Roboy/m3/README.md

# m3
myo mini muscle
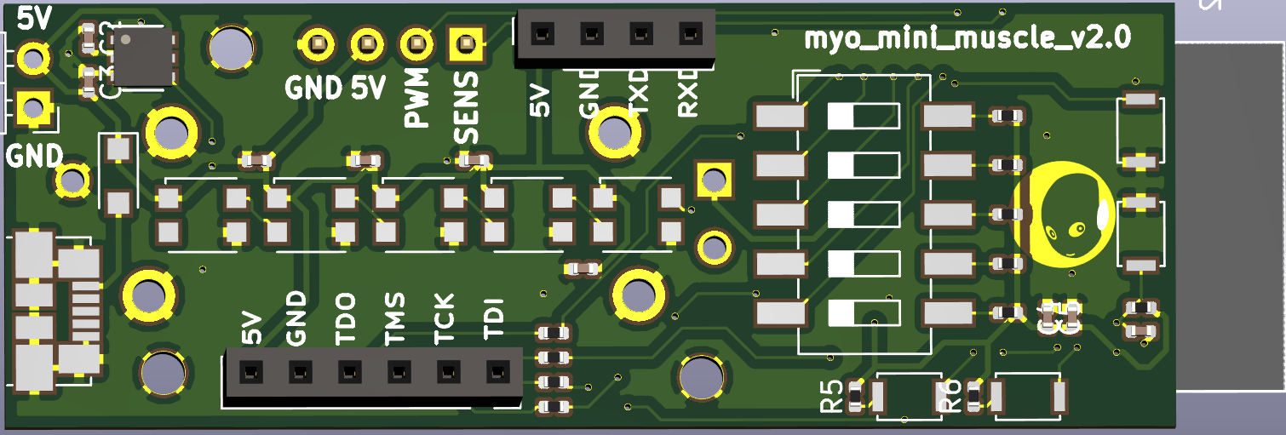
[picture p1: images/m3.png]
m3

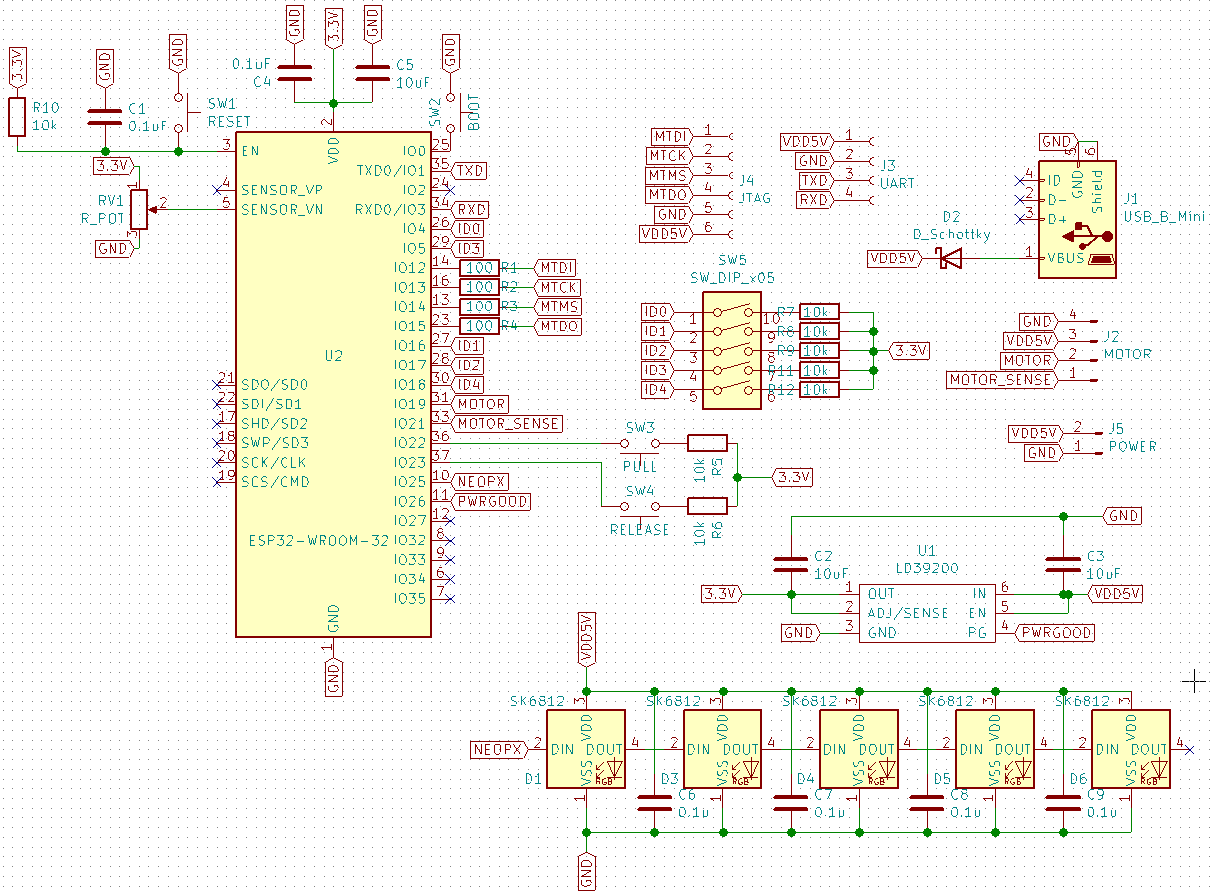
[picture p2: images/m3_schematics.png]
m3_schematics
