Roboy/m3/datasheet/esp32-pinout-chip-ESP-WROOM-32.png

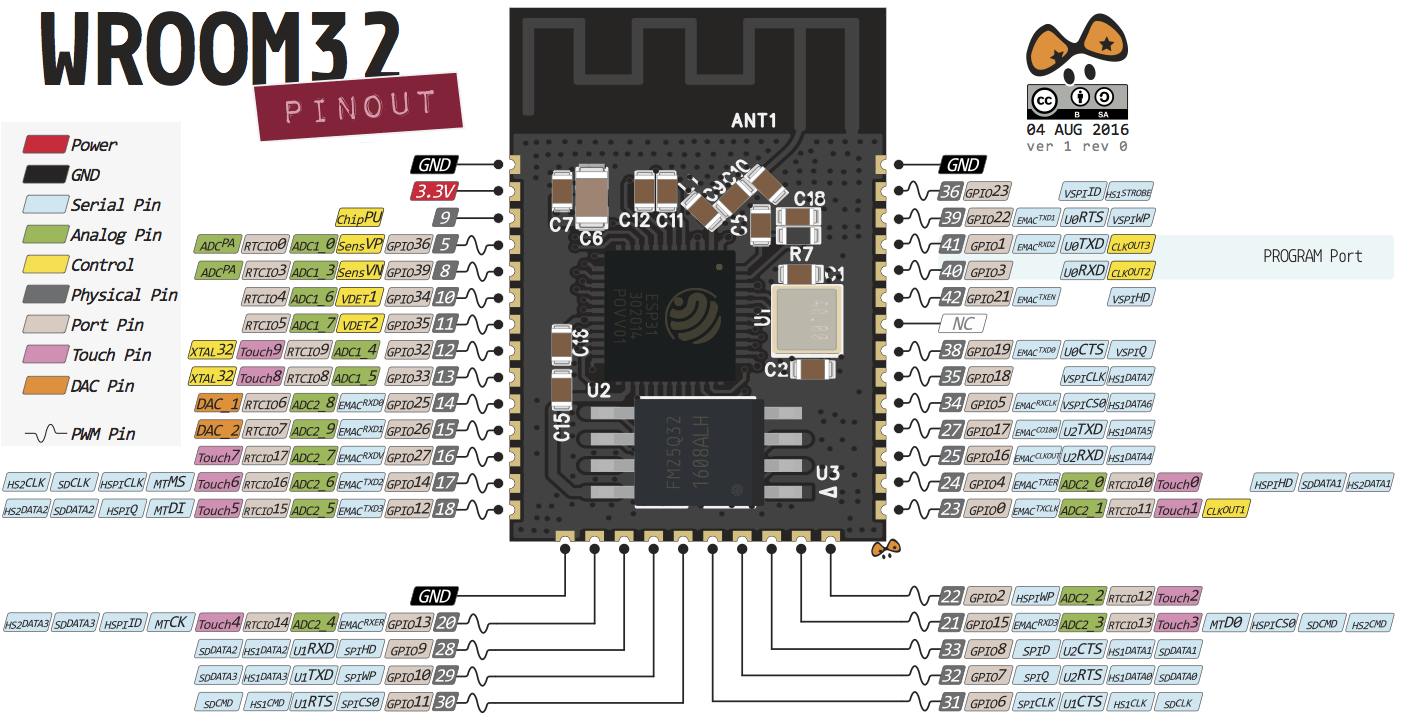
datasheet/esp32-pinout-chip-ESP-WROOM-32.png
