Roboy/m3/_3Dmodels/4UCON_17809/4UCON_17809_02x10x1.27mm_Vertical.step

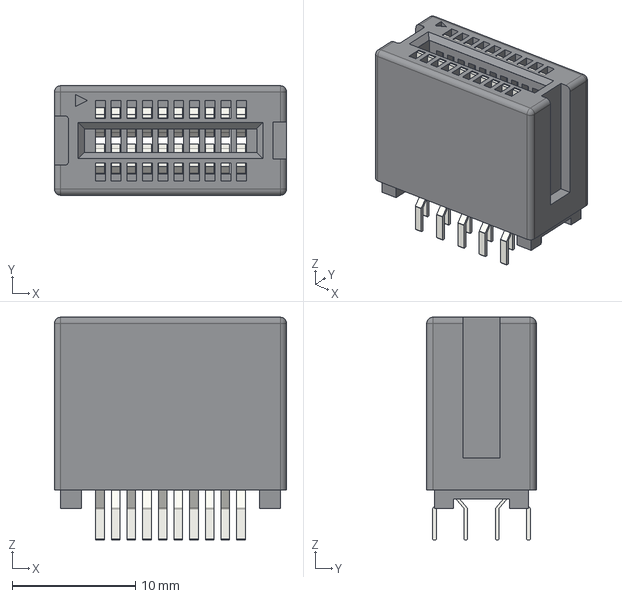
[picture p4: CAD file, 2019-02-02]
_3Dmodels/4UCON_17809/4UCON_17809_02x10x1.27mm_Vertical.step
18.8 x 8.88 x 18.0 mm
