Roboy/m3/_3Dmodels/BGA_packages/Texas_Junior_DSBGA-12_4x3_2.5x2.0mm_Pitch0.5mm_Dia0.30mm.step

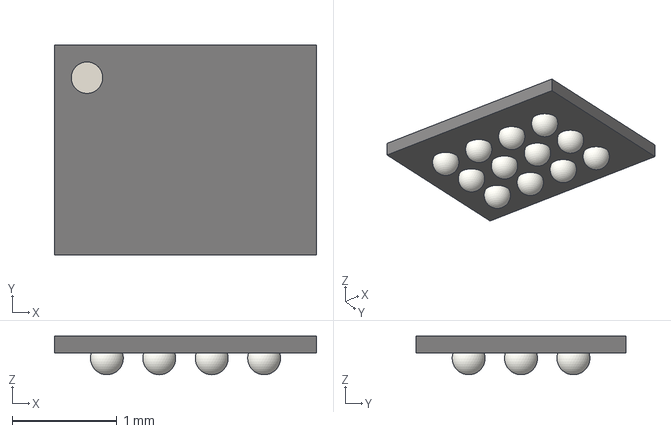
[picture p5: CAD file, 2019-02-02]
_3Dmodels/BGA_packages/Texas_Junior_DSBGA-12_4x3_2.5x2.0mm_Pitch0.5mm_Dia0.30mm.step
2.50 x 2.00 x 0.367 mm
