Roboy/m3/_3Dmodels/Box_Headers/Box_Header_Straight_2x25x2.54mm.step

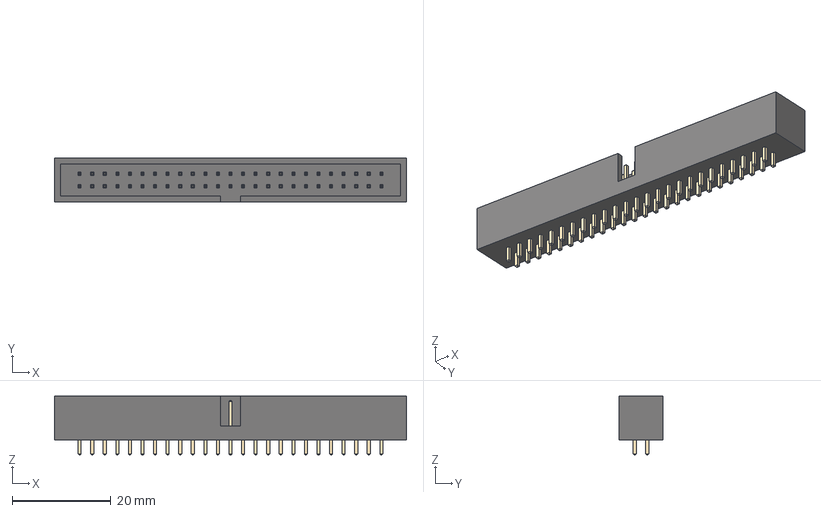
[picture p6: CAD file, 2019-02-02]
_3Dmodels/Box_Headers/Box_Header_Straight_2x25x2.54mm.step
71.1 x 8.90 x 11.9 mm
