Roboy/m3/_3Dmodels/Capacitors_Radial_THT/CP_Radial_D10.0mm_P7.50mm.step

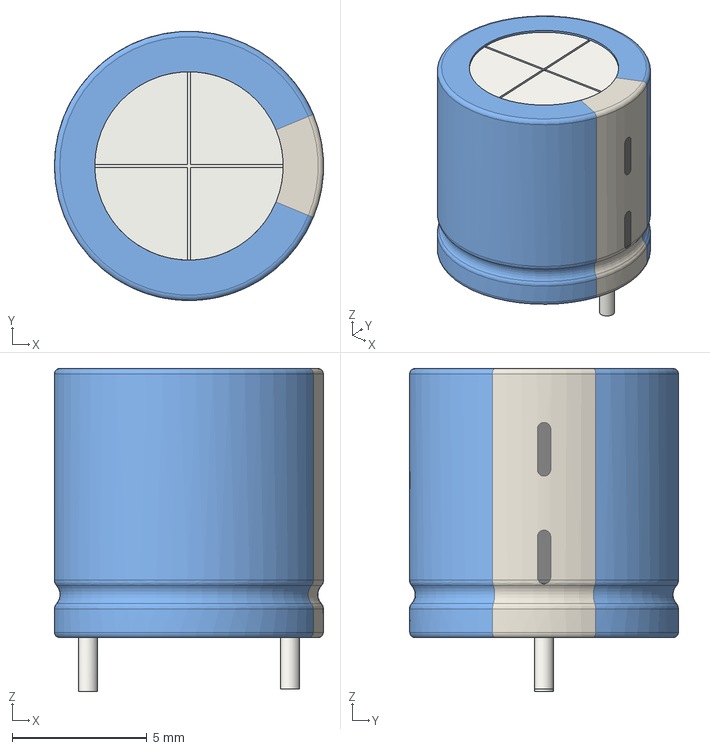
[picture p8: CAD file, 2019-02-02]
_3Dmodels/Capacitors_Radial_THT/CP_Radial_D10.0mm_P7.50mm.step
10.00 x 9.99 x 12.0 mm
