Roboy/m3/_3Dmodels/Capacitors_Rect_THT/C_Rect_L4.6mm_W5.5mm_P2.50mm_MKS02_FKP02.step

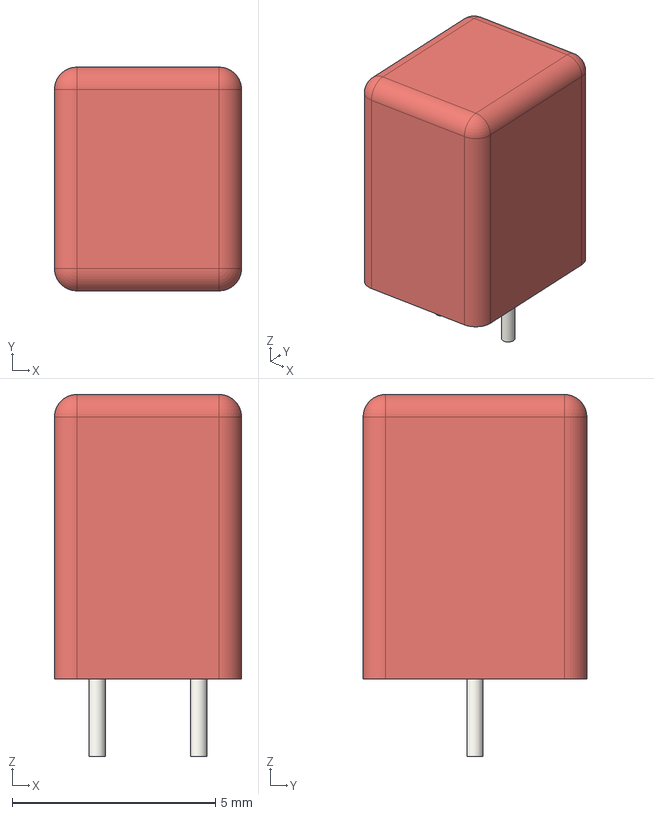
[picture p9: CAD file, 2019-02-02]
_3Dmodels/Capacitors_Rect_THT/C_Rect_L4.6mm_W5.5mm_P2.50mm_MKS02_FKP02.step
4.60 x 5.50 x 8.90 mm
