Roboy/m3/_3Dmodels/Diodes_SMD/D_SMA.step

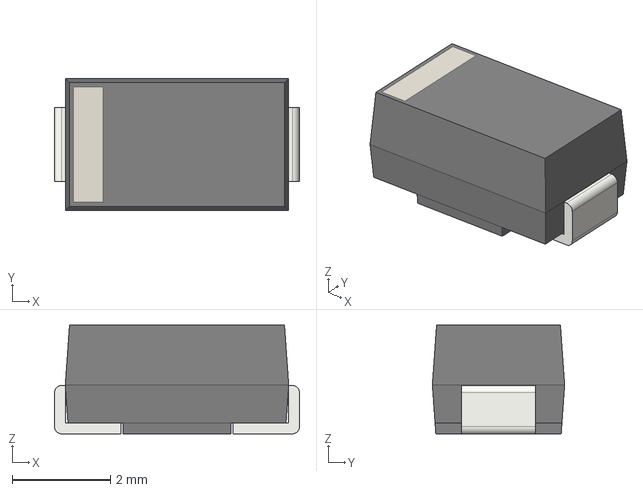
[picture p10: CAD file, 2019-02-02]
_3Dmodels/Diodes_SMD/D_SMA.step
5.00 x 2.70 x 2.22 mm
