Roboy/m3/_3Dmodels/ESP32/ESP32-WROOM-32D--3DModel-STEP-56544.STEP

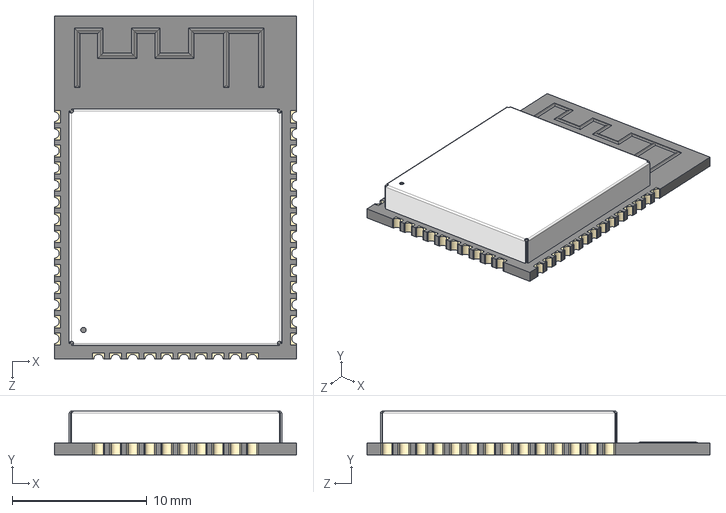
[picture p12: CAD file, 2019-05-12]
_3Dmodels/ESP32/ESP32-WROOM-32D--3DModel-STEP-56544.STEP
18.0 x 3.25 x 25.5 mm
