Roboy/m3/roboy_sno1.step

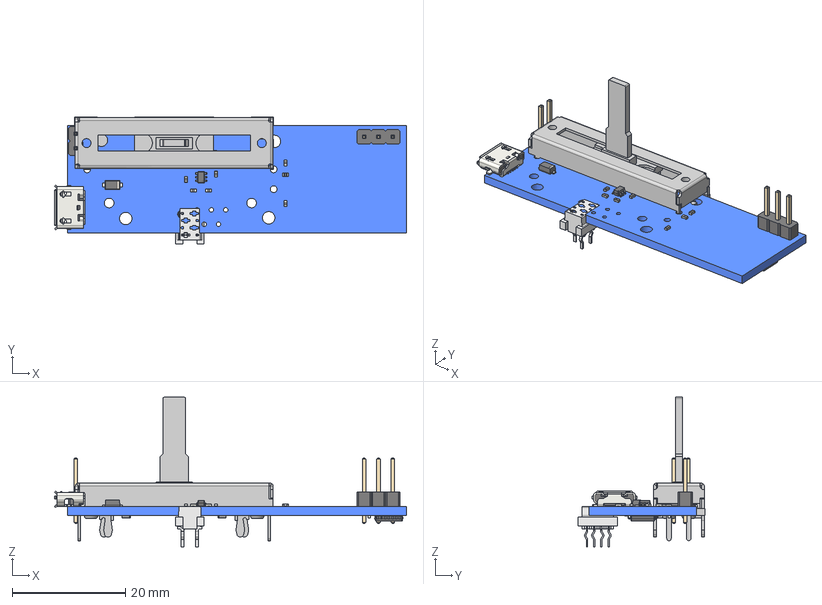
[picture p15: CAD file, 2019-02-02]
roboy_sno1.step
62.3 x 22.5 x 26.4 mm
Pcb
Potentiometer_Bourns_PTA2043_Single_Slide_
DFN_6_1EP_3x3mm_Pitch095mm_
C_0402_
C_0402_001
D_SOD_123F_
USB_Micro-B_Molex_47346-0001_
PinHeader_1x02_P254mm_Vertical_
SOT_363_SC_70_6_
R_0402_
R_0402_001
R_0402_002
R_0402_003
C_0402_002
C_0402_003
PinHeader_1x03_P254mm_Vertical_
TSSOP_14_44x5mm_Pitch065mm_
R_0402_004
R_0402_005
R_0402_006
C-215079-4_
R_0402_1005Metric_
R_0402_1005Metric_001
R_0402_1005Metric_002
