Roboy/m3/_3Dmodels/4UCON_17809/4UCON_17809_02x40x1.27mm_Vertical.FCStd

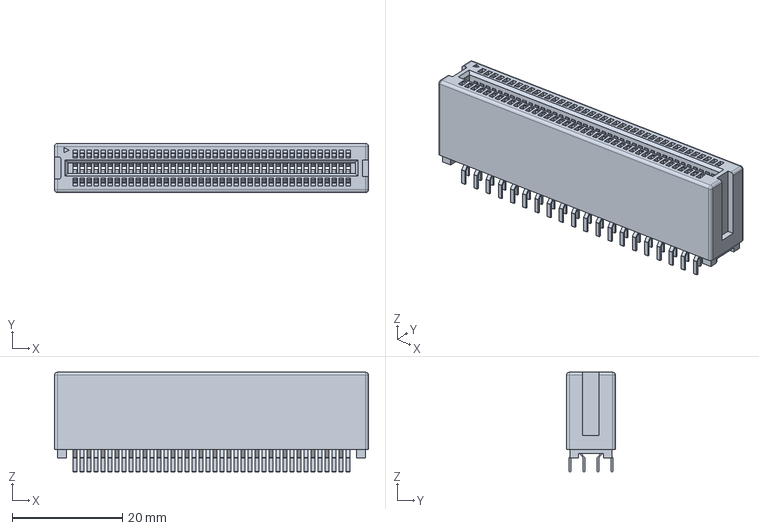
[picture p16: CAD file, 2019-02-02]
_3Dmodels/4UCON_17809/4UCON_17809_02x40x1.27mm_Vertical.FCStd
56.9 x 8.88 x 18.0 mm
