Roboy/m3/_3Dmodels/Capacitors_Radial_SMD/CP_Elec_8x6.5.step

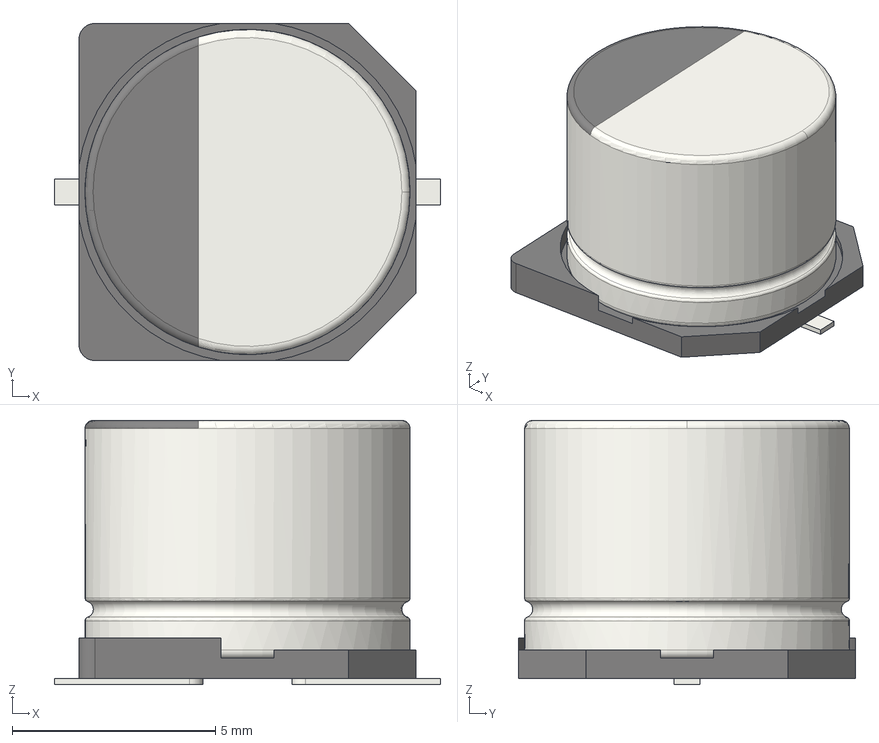
[picture p19: CAD file, 2019-02-02]
_3Dmodels/Capacitors_Radial_SMD/CP_Elec_8x6.5.step
9.50 x 8.30 x 6.50 mm
