Roboy/m3/_3Dmodels/Capacitors_Radial_THT/CP_Radial_D8.0mm_P5.00mm.step

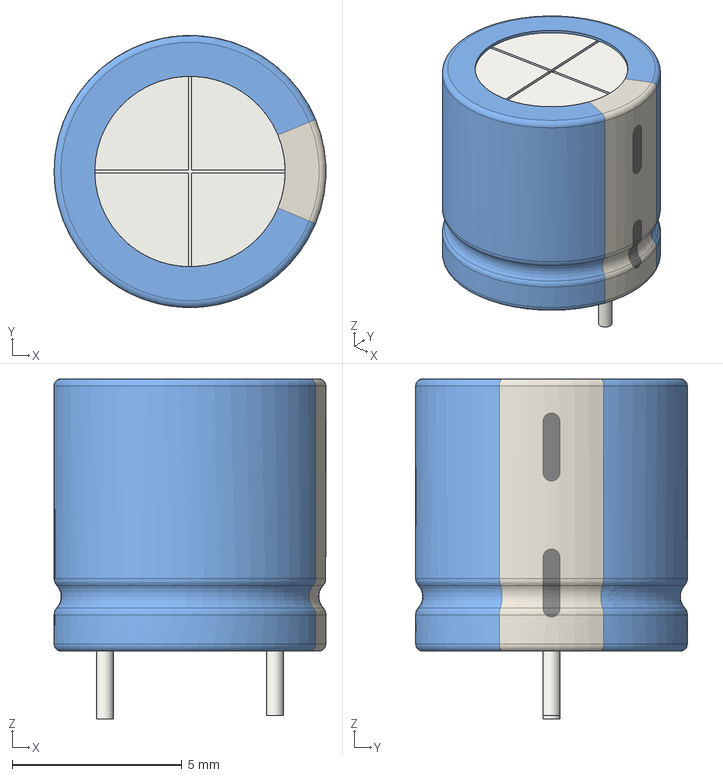
[picture p20: CAD file, 2019-02-02]
_3Dmodels/Capacitors_Radial_THT/CP_Radial_D8.0mm_P5.00mm.step
8.00 x 8.00 x 10.0 mm
