Roboy/m3/_3Dmodels/Diodes_SMD/D_SMC.step

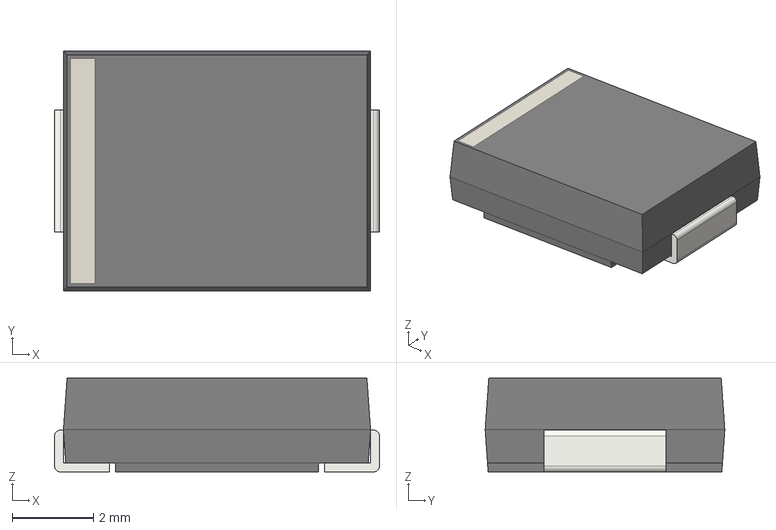
[picture p22: CAD file, 2019-02-02]
_3Dmodels/Diodes_SMD/D_SMC.step
8.00 x 5.90 x 2.31 mm
