Roboy/m3/_3Dmodels/DIP_packages/DIP-24_W10.16mm.step

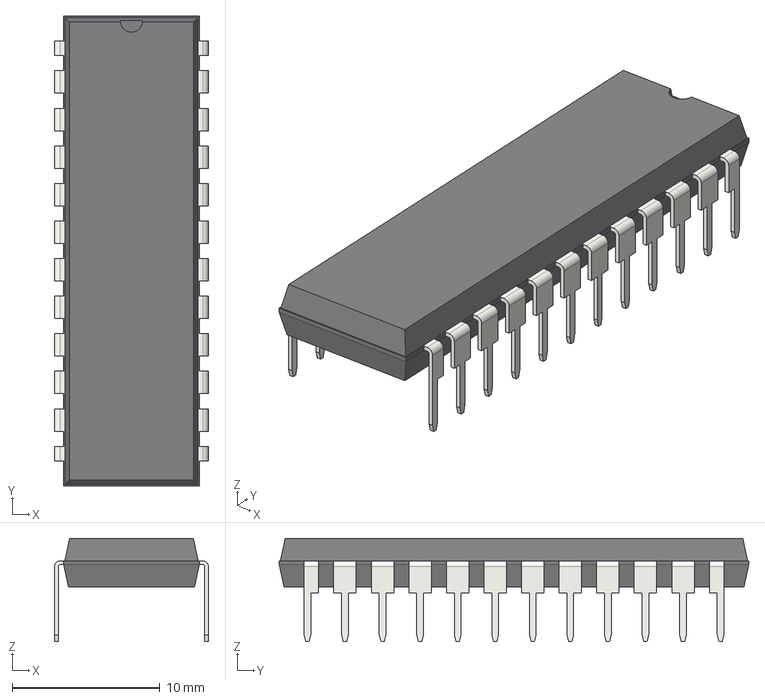
[picture p23: CAD file, 2019-02-02]
_3Dmodels/DIP_packages/DIP-24_W10.16mm.step
10.4 x 31.8 x 6.98 mm
