Roboy/m3/_3Dmodels/GullWings_packages/QFP/LQFP-44_10x10mm_Pitch0.8mm.step

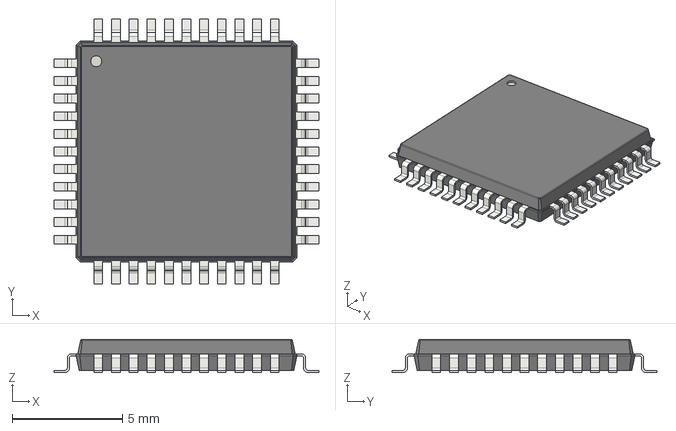
[picture p24: CAD file, 2019-02-02]
_3Dmodels/GullWings_packages/QFP/LQFP-44_10x10mm_Pitch0.8mm.step
12.0 x 12.0 x 1.50 mm
