Roboy/m3/_3Dmodels/BGA_packages/BGA-1156_34x34_35.0x35.0mm_Pitch1.0mm.step

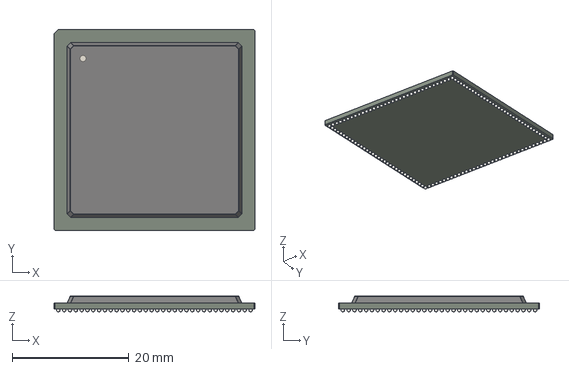
[picture p26: CAD file, 2019-02-02]
_3Dmodels/BGA_packages/BGA-1156_34x34_35.0x35.0mm_Pitch1.0mm.step
34.5 x 34.5 x 2.72 mm
