Roboy/m3/_3Dmodels/Capacitors_Rect_THT/C_Rect_L11.5mm_W6.4mm_P10.00mm_MKT.step

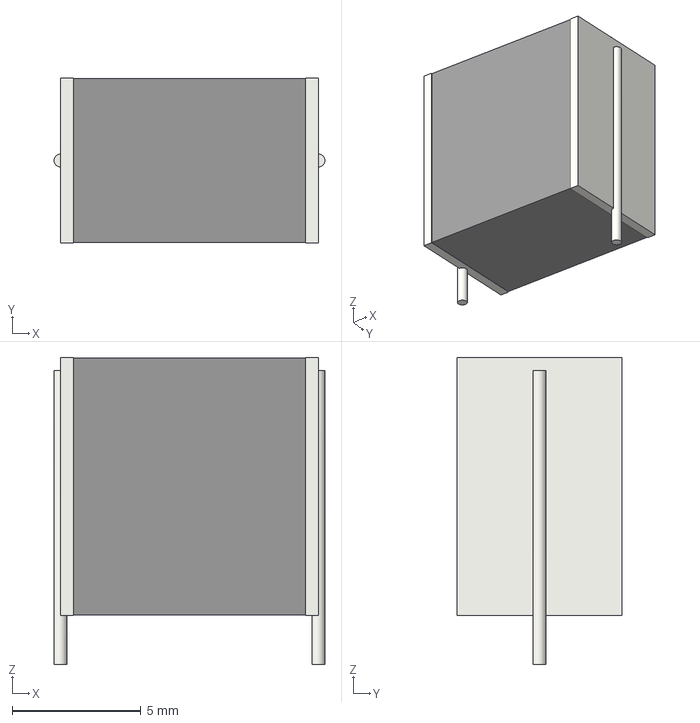
[picture p29: CAD file, 2019-02-02]
_3Dmodels/Capacitors_Rect_THT/C_Rect_L11.5mm_W6.4mm_P10.00mm_MKT.step
10.5 x 6.40 x 11.9 mm
