Roboy/m3/_3Dmodels/Diodes_SMD/D_SMB.step

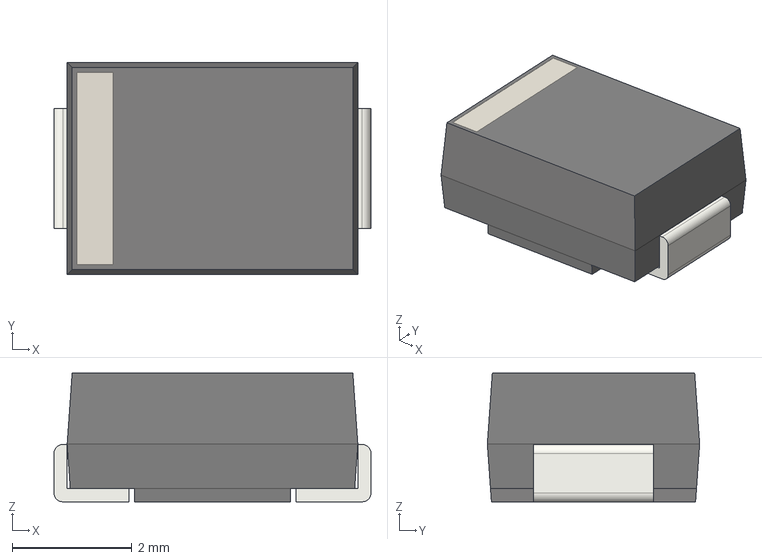
[picture p30: CAD file, 2019-02-02]
_3Dmodels/Diodes_SMD/D_SMB.step
5.30 x 3.55 x 2.15 mm
