Roboy/m3/_3Dmodels/DIP_packages/DIP-64_W22.86mm.step

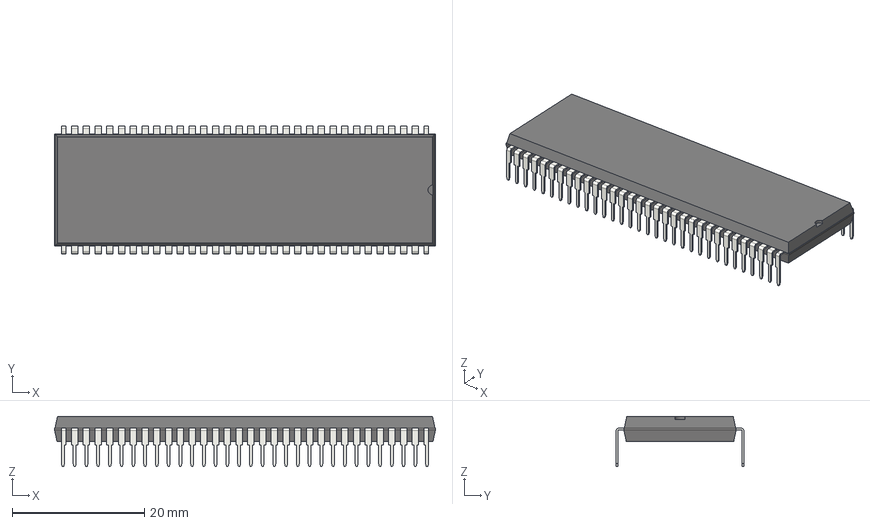
[picture p31: CAD file, 2019-02-02]
_3Dmodels/DIP_packages/DIP-64_W22.86mm.step
57.7 x 19.3 x 7.62 mm
