Roboy/m3/_3Dmodels/GullWings_packages/QFP/LQFP-128_14x14mm_Pitch0.4mm.step

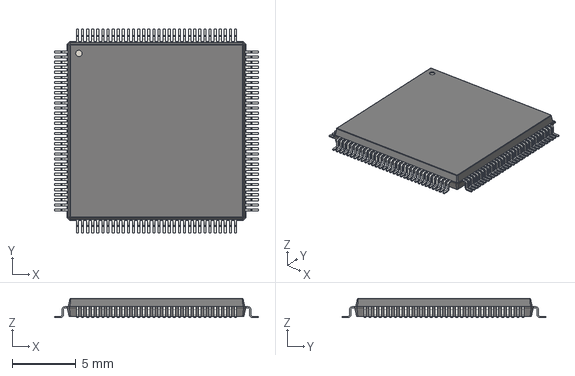
[picture p32: CAD file, 2019-02-02]
_3Dmodels/GullWings_packages/QFP/LQFP-128_14x14mm_Pitch0.4mm.step
16.0 x 16.0 x 1.50 mm
