Roboy/m3/_3Dmodels/GullWings_packages/SOIC/SOIC-20W_7.5x12.8mm_Pitch1.27mm.step

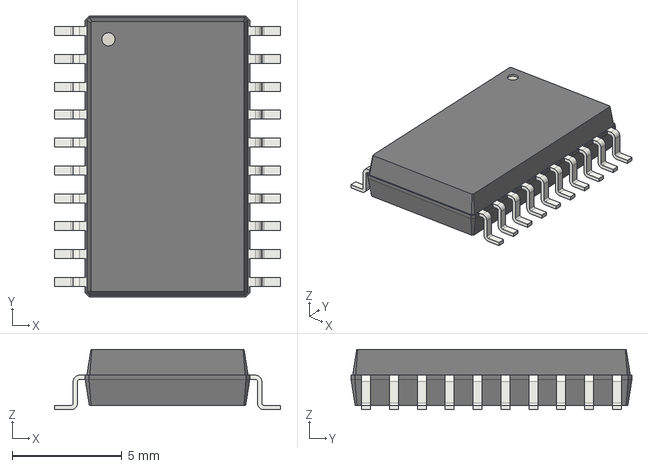
[picture p33: CAD file, 2019-02-02]
_3Dmodels/GullWings_packages/SOIC/SOIC-20W_7.5x12.8mm_Pitch1.27mm.step
10.3 x 12.8 x 2.75 mm
