Roboy/m3/_3Dmodels/Capacitors_Radial_THT/CP_Radial_D10.0mm_P3.80mm.step

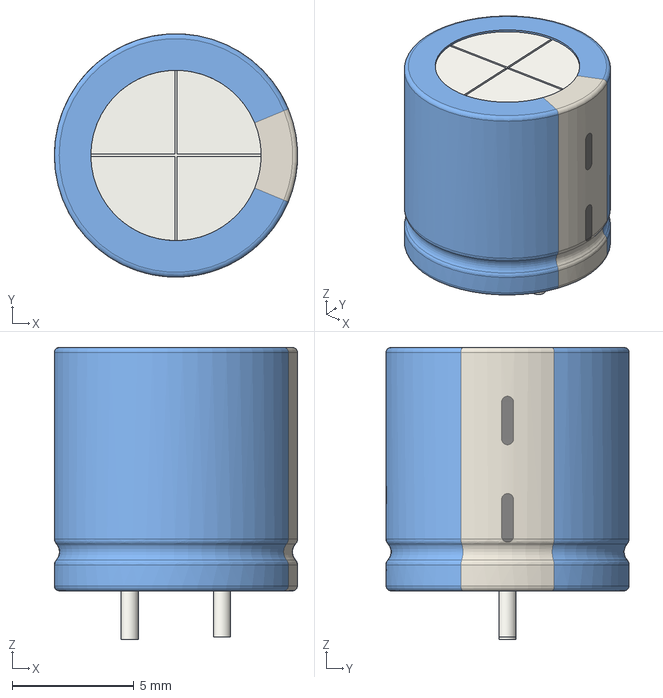
[picture p37: CAD file, 2019-02-02]
_3Dmodels/Capacitors_Radial_THT/CP_Radial_D10.0mm_P3.80mm.step
10.00 x 9.99 x 12.0 mm
