Roboy/m3/_3Dmodels/Capacitors_Rect_THT/C_Rect_L26.5mm_W8.5mm_P22.50mm_MKS4.step

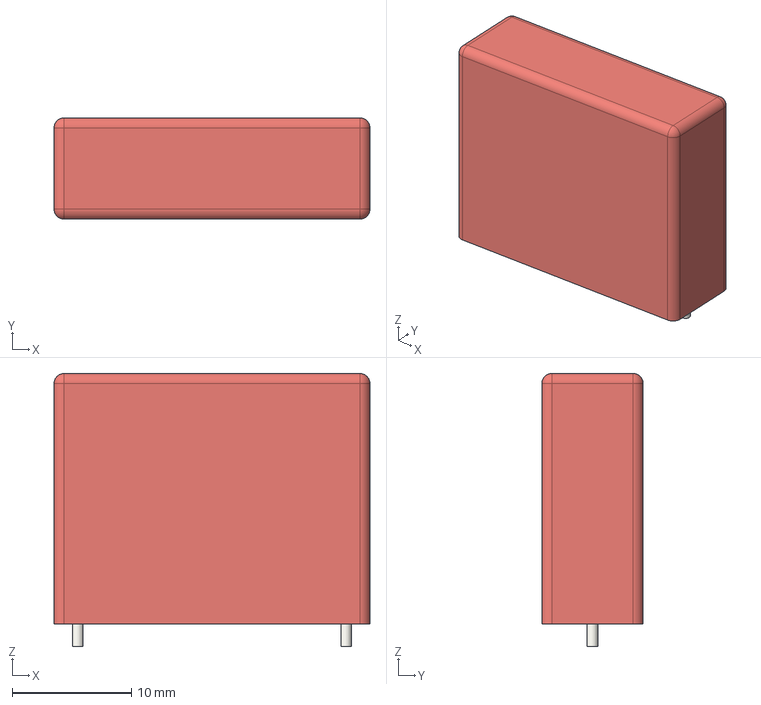
[picture p38: CAD file, 2019-02-02]
_3Dmodels/Capacitors_Rect_THT/C_Rect_L26.5mm_W8.5mm_P22.50mm_MKS4.step
26.5 x 8.50 x 22.9 mm
