Roboy/m3/_3Dmodels/DIP_packages/DIP-4_W7.62mm.step

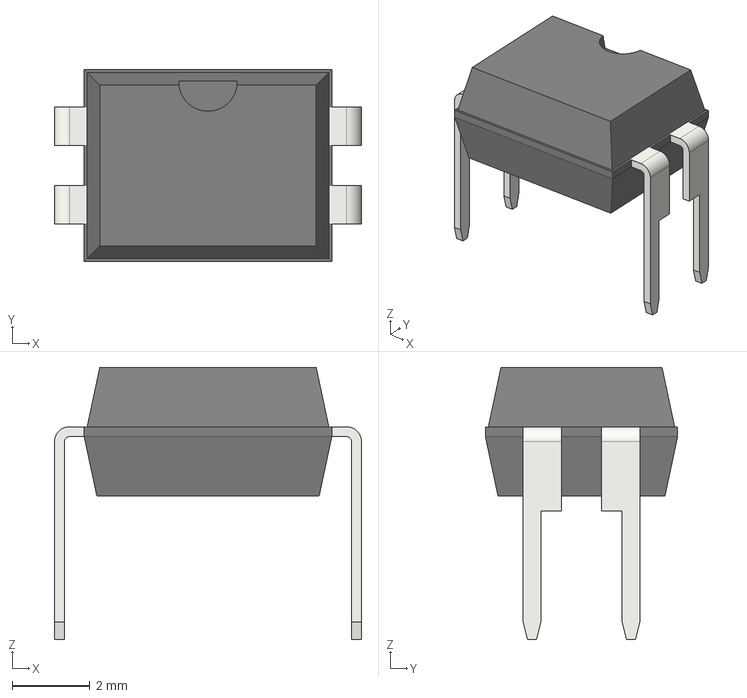
[picture p39: CAD file, 2019-02-02]
_3Dmodels/DIP_packages/DIP-4_W7.62mm.step
7.87 x 4.93 x 6.98 mm
