Roboy/m3/_3Dmodels/GullWings_packages/QFP/LQFP-32_5x5mm_Pitch0.5mm.step

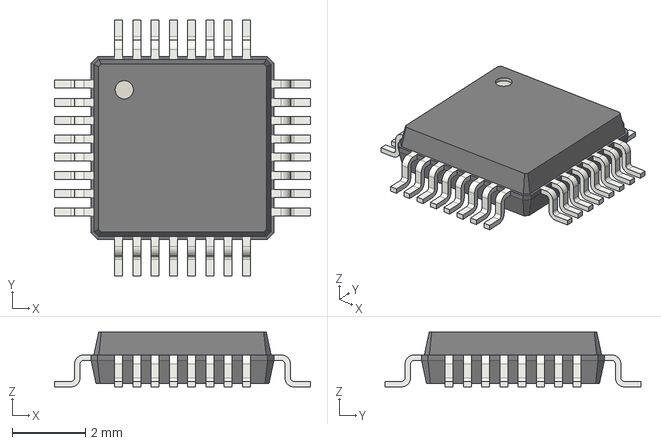
[picture p40: CAD file, 2019-02-02]
_3Dmodels/GullWings_packages/QFP/LQFP-32_5x5mm_Pitch0.5mm.step
7.00 x 7.00 x 1.50 mm
