Roboy/m3/_3Dmodels/GullWings_packages/SOIC/SOIC-16_3.9x9.9mm_Pitch1.27mm.step

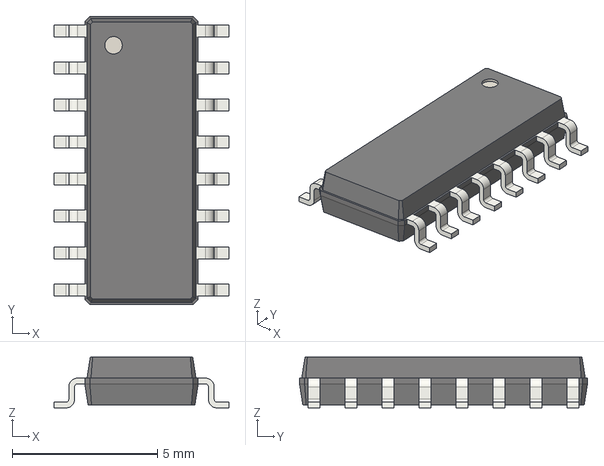
[picture p41: CAD file, 2019-02-02]
_3Dmodels/GullWings_packages/SOIC/SOIC-16_3.9x9.9mm_Pitch1.27mm.step
6.00 x 9.90 x 1.75 mm
