Roboy/m3/_3Dmodels/Capacitors_Radial_SMD/CP_Elec_6.3x5.8.step

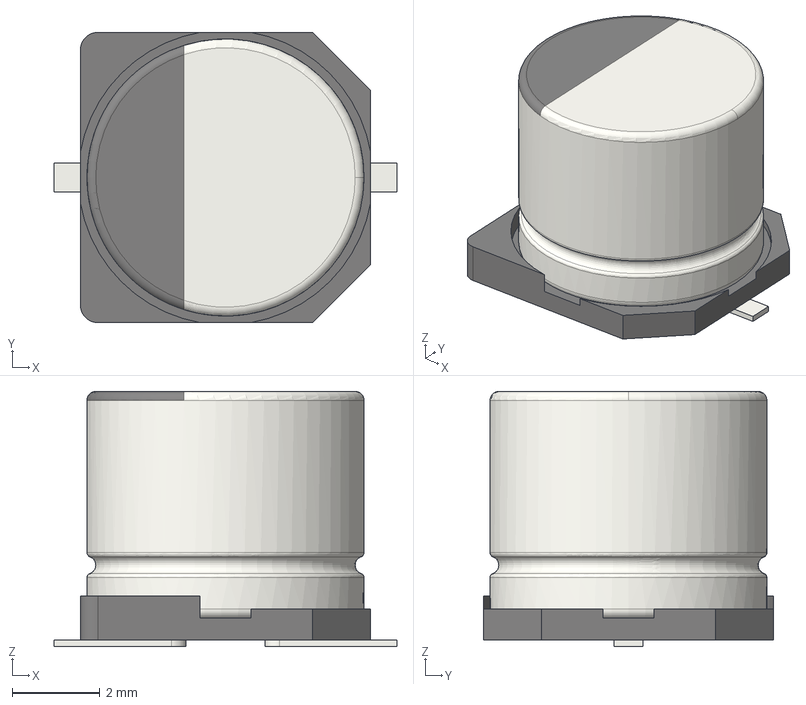
[picture p44: CAD file, 2019-02-02]
_3Dmodels/Capacitors_Radial_SMD/CP_Elec_6.3x5.8.step
7.80 x 6.60 x 5.80 mm
