Roboy/m3/_3Dmodels/Capacitors_Rect_THT/C_Rect_L7.0mm_W2.0mm_P5.00mm.step

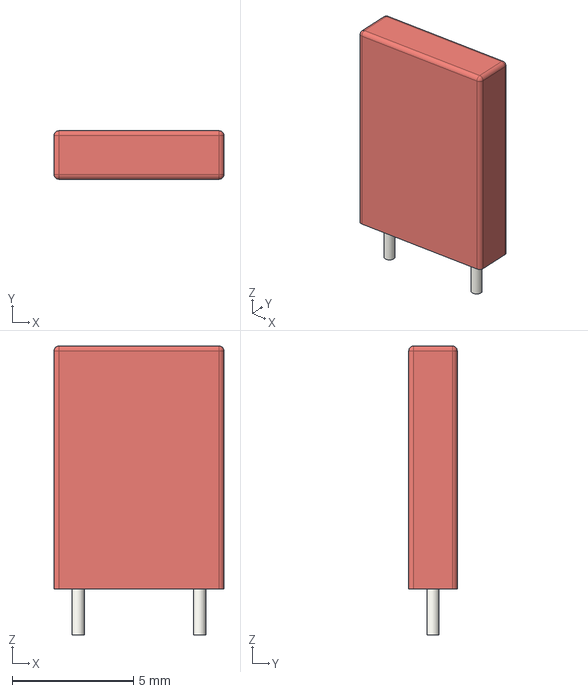
[picture p46: CAD file, 2019-02-02]
_3Dmodels/Capacitors_Rect_THT/C_Rect_L7.0mm_W2.0mm_P5.00mm.step
7.00 x 2.00 x 11.9 mm
