Roboy/m3/_3Dmodels/DIP_packages/DIP-22_W7.62mm.step

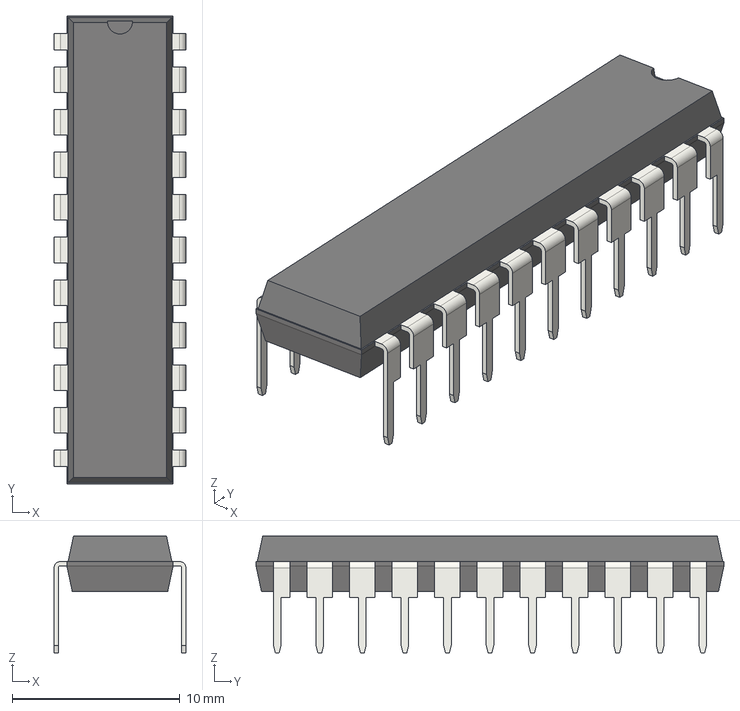
[picture p47: CAD file, 2019-02-02]
_3Dmodels/DIP_packages/DIP-22_W7.62mm.step
7.87 x 27.9 x 6.98 mm
