Roboy/m3/_3Dmodels/GullWings_packages/QFP/TQFP-48-1EP_7x7mm_Pitch0.5mm.step

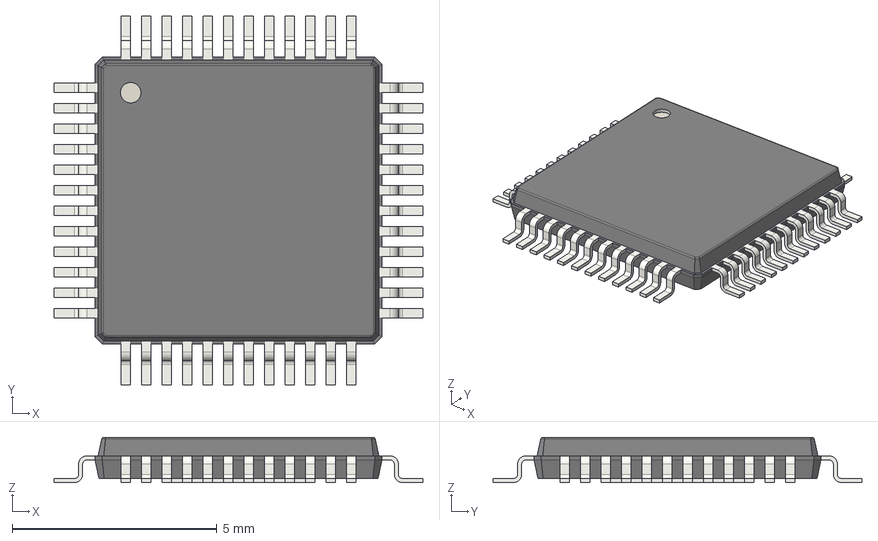
[picture p48: CAD file, 2019-02-02]
_3Dmodels/GullWings_packages/QFP/TQFP-48-1EP_7x7mm_Pitch0.5mm.step
9.00 x 9.00 x 1.10 mm
