Roboy/m3/_3Dmodels/BGA_packages/BGA-1023_32x32_33.0x33.0mm_Pitch1.0mm.step

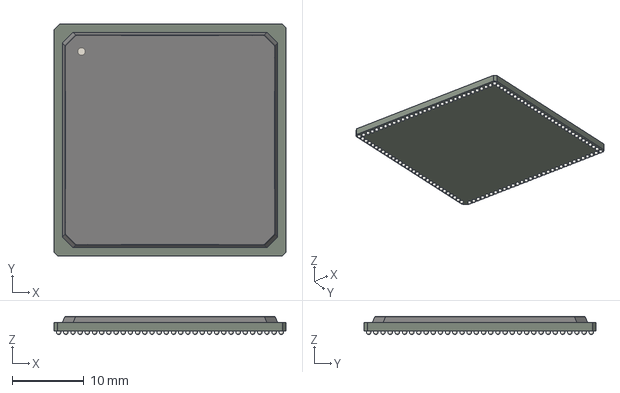
[picture p50: CAD file, 2019-02-02]
_3Dmodels/BGA_packages/BGA-1023_32x32_33.0x33.0mm_Pitch1.0mm.step
32.3 x 32.3 x 2.52 mm
