Roboy/m3/_3Dmodels/Capacitors_Radial_SMD/CP_Elec_6.3x5.7.step

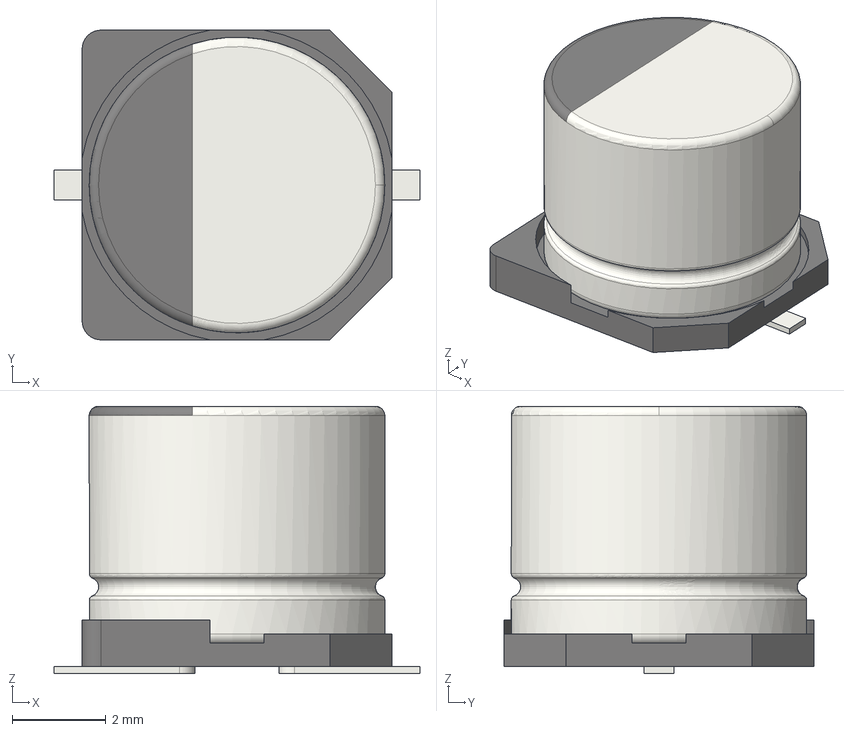
[picture p52: CAD file, 2019-02-02]
_3Dmodels/Capacitors_Radial_SMD/CP_Elec_6.3x5.7.step
7.80 x 6.60 x 5.70 mm
