Roboy/m3/_3Dmodels/Capacitors_Radial_THT/CP_Radial_D22.0mm_P10.00mm_SnapIn.step

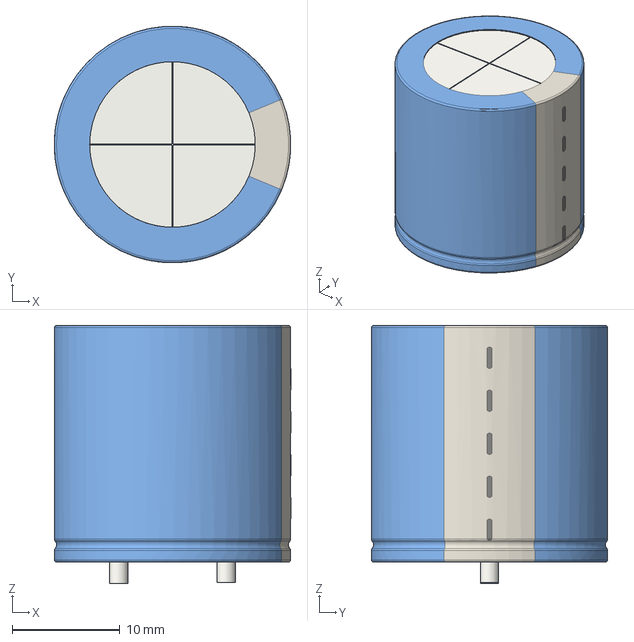
[picture p53: CAD file, 2019-02-02]
_3Dmodels/Capacitors_Radial_THT/CP_Radial_D22.0mm_P10.00mm_SnapIn.step
22.0 x 22.0 x 24.0 mm
