Roboy/m3/_3Dmodels/DIP_packages/DIP-22_W10.16mm.step

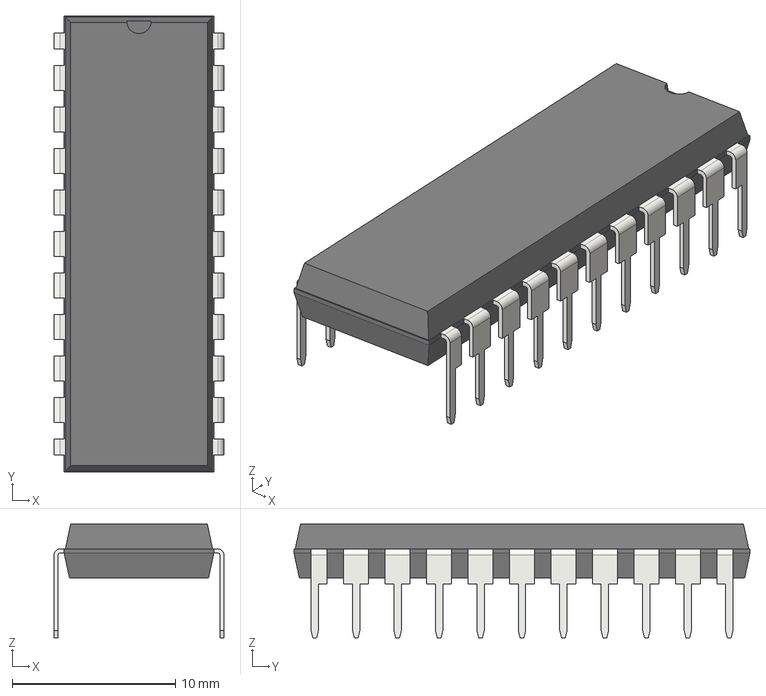
[picture p55: CAD file, 2019-02-02]
_3Dmodels/DIP_packages/DIP-22_W10.16mm.step
10.4 x 27.9 x 6.98 mm
