Roboy/m3/_3Dmodels/GullWings_packages/QFP/TQFP-100_14x14mm_Pitch0.5mm.step

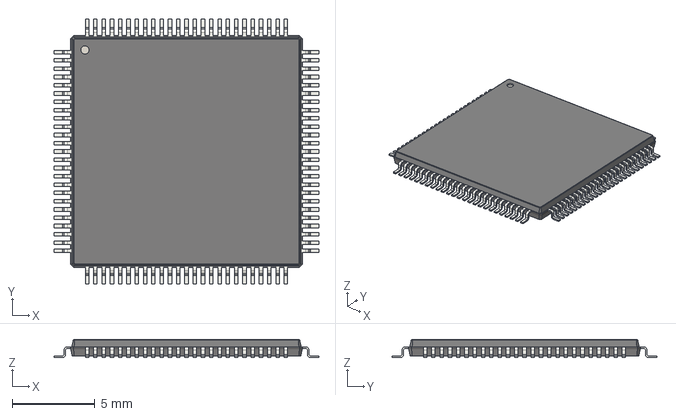
[picture p56: CAD file, 2019-02-02]
_3Dmodels/GullWings_packages/QFP/TQFP-100_14x14mm_Pitch0.5mm.step
16.0 x 16.0 x 1.10 mm
