Roboy/m3/_3Dmodels/BGA_packages/BGA-625_25x25_21.0x21.0mm_Pitch0.8mm.step

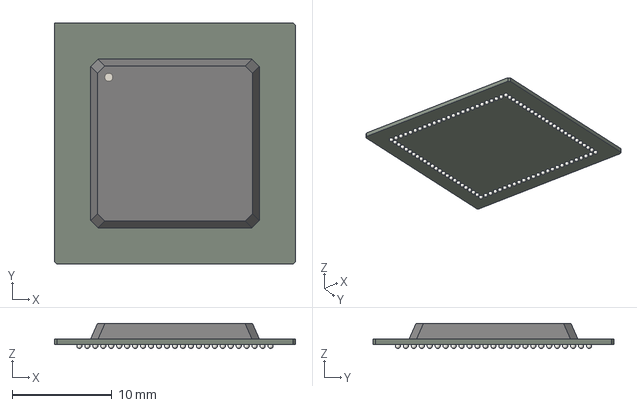
[picture p58: CAD file, 2019-02-02]
_3Dmodels/BGA_packages/BGA-625_25x25_21.0x21.0mm_Pitch0.8mm.step
24.2 x 24.2 x 2.51 mm
