Roboy/m3/_3Dmodels/GullWings_packages/QFP/TQFP-64_14x14mm_Pitch0.8mm.step

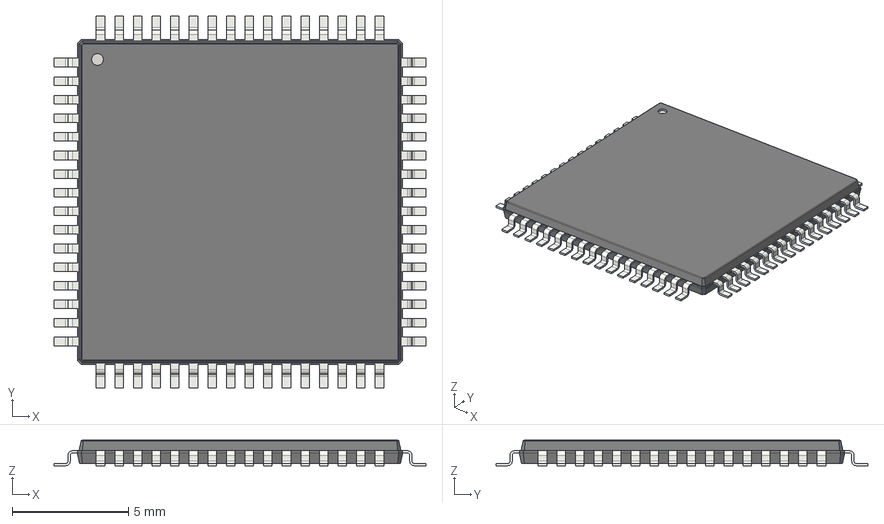
[picture p63: CAD file, 2019-02-02]
_3Dmodels/GullWings_packages/QFP/TQFP-64_14x14mm_Pitch0.8mm.step
16.0 x 16.0 x 1.10 mm
