Roboy/m3/_3Dmodels/Capacitors_Radial_THT/CP_Radial_D13.0mm_P5.00mm.step

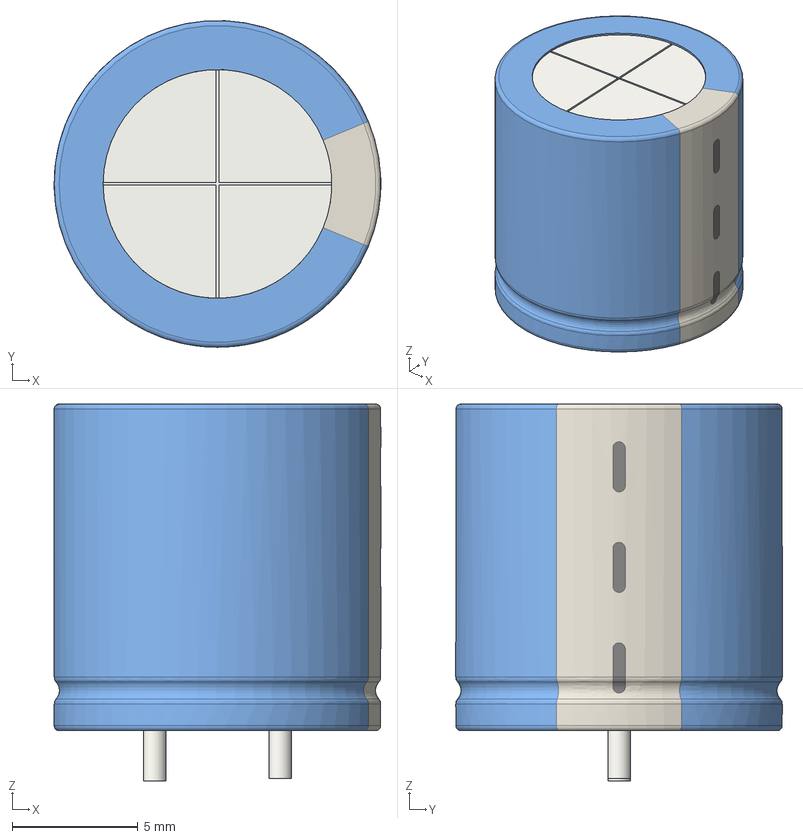
[picture p68: CAD file, 2019-02-02]
_3Dmodels/Capacitors_Radial_THT/CP_Radial_D13.0mm_P5.00mm.step
13.0 x 13.0 x 15.0 mm
