Roboy/m3/_3Dmodels/DIP_packages/DIP-40_W15.24mm.step

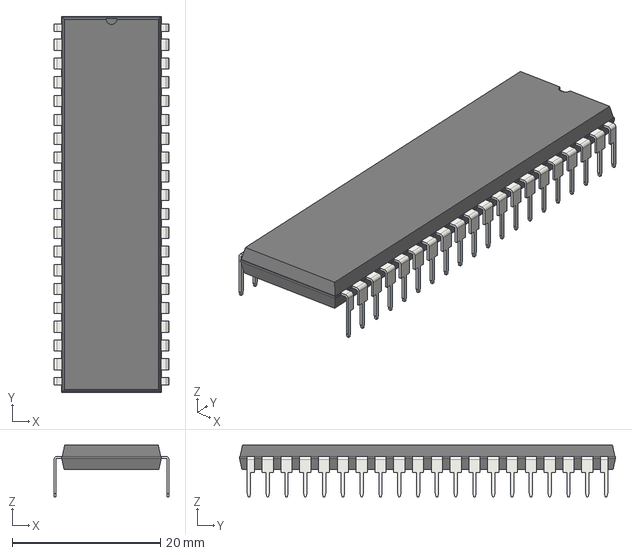
[picture p70: CAD file, 2019-02-02]
_3Dmodels/DIP_packages/DIP-40_W15.24mm.step
15.5 x 50.8 x 6.98 mm
