Roboy/m3/_3Dmodels/GullWings_packages/SOIC/SOIC-14_3.9x8.7mm_Pitch1.27mm.step

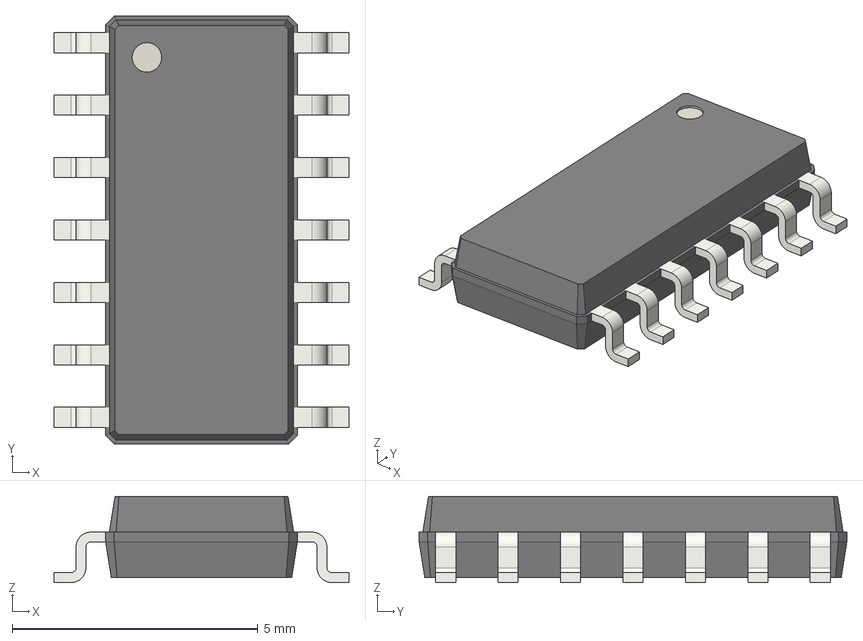
[picture p72: CAD file, 2019-02-02]
_3Dmodels/GullWings_packages/SOIC/SOIC-14_3.9x8.7mm_Pitch1.27mm.step
6.00 x 8.70 x 1.75 mm
