Roboy/m3/_3Dmodels/DIP_packages/DIP-24_W15.24mm.step

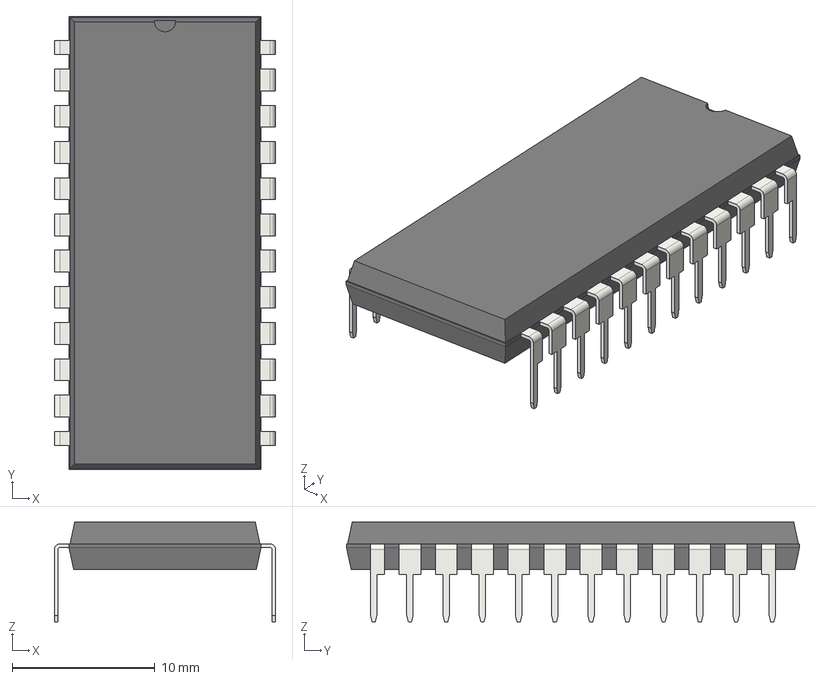
[picture p76: CAD file, 2019-02-02]
_3Dmodels/DIP_packages/DIP-24_W15.24mm.step
15.5 x 31.8 x 6.98 mm
