Roboy/m3/_3Dmodels/Capacitors_Radial_SMD/CP_Elec_4x4.5.step

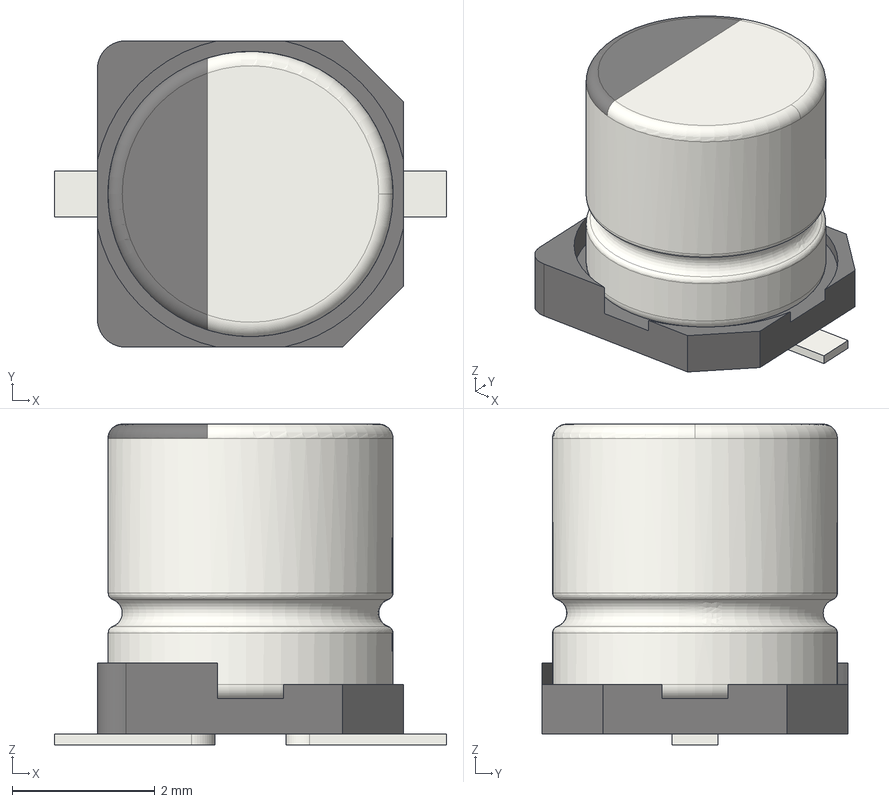
[picture p81: CAD file, 2019-02-02]
_3Dmodels/Capacitors_Radial_SMD/CP_Elec_4x4.5.step
5.50 x 4.30 x 4.50 mm
