Roboy/m3/_3Dmodels/Capacitors_Radial_THT/CP_Radial_D5.0mm_P2.50mm.step

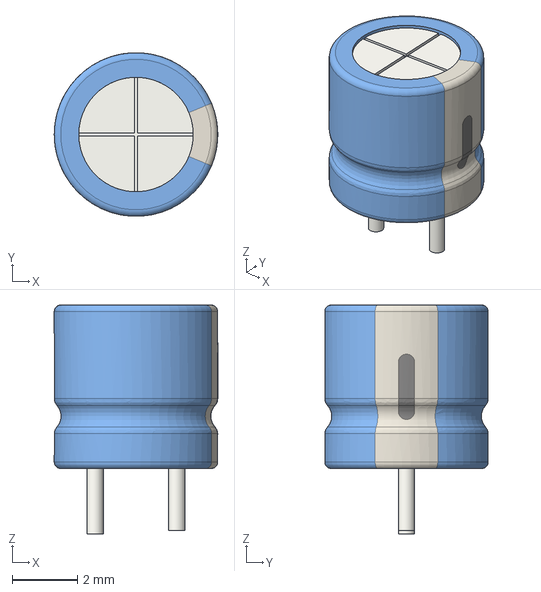
[picture p82: CAD file, 2019-02-02]
_3Dmodels/Capacitors_Radial_THT/CP_Radial_D5.0mm_P2.50mm.step
5.00 x 5.00 x 7.00 mm
