Roboy/m3/_3Dmodels/DIP_packages/DIP-6_W7.62mm.step

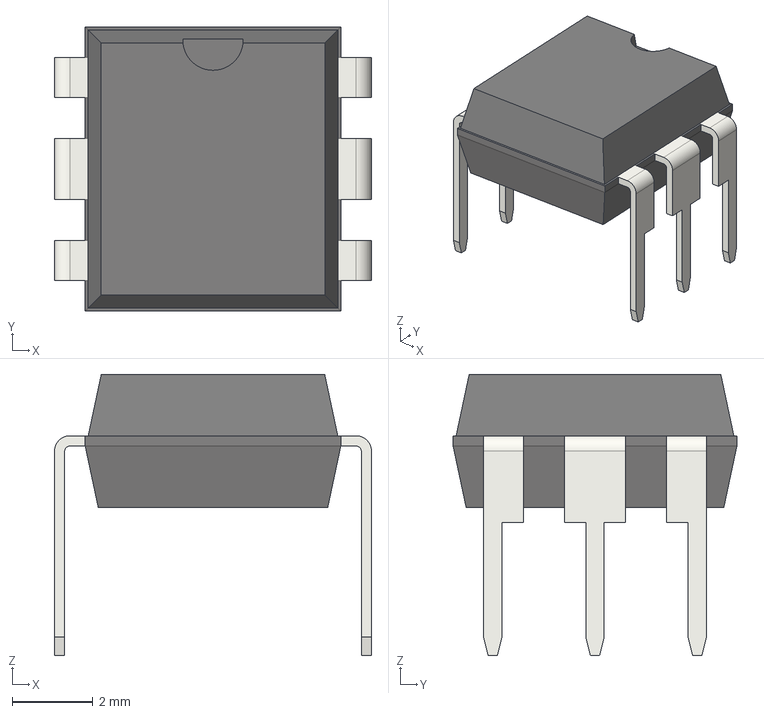
[picture p84: CAD file, 2019-02-02]
_3Dmodels/DIP_packages/DIP-6_W7.62mm.step
7.87 x 7.05 x 6.98 mm
