Roboy/m3/_3Dmodels/GullWings_packages/SOIC/SOIC-16W_7.5x10.3mm_Pitch1.27mm.step

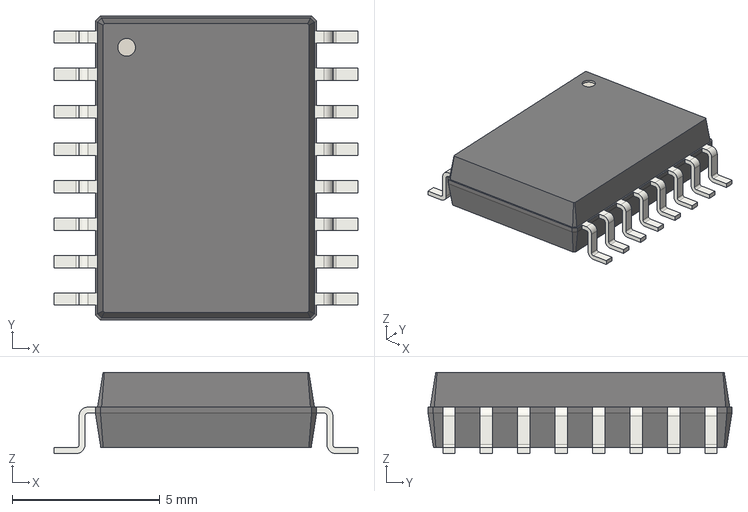
[picture p86: CAD file, 2019-02-02]
_3Dmodels/GullWings_packages/SOIC/SOIC-16W_7.5x10.3mm_Pitch1.27mm.step
10.3 x 10.3 x 2.75 mm
