Roboy/m3/_3Dmodels/Capacitors_Radial_SMD/CP_Elec_5x5.3.step

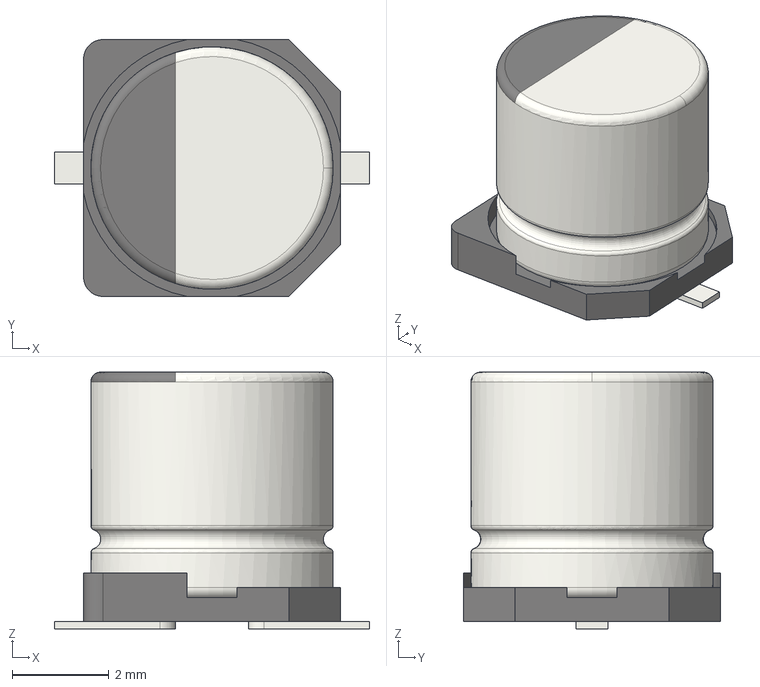
[picture p88: CAD file, 2019-02-02]
_3Dmodels/Capacitors_Radial_SMD/CP_Elec_5x5.3.step
6.50 x 5.30 x 5.30 mm
