Roboy/m3/_3Dmodels/GullWings_packages/SOIC/SOIC-18W_7.5x11.6mm_Pitch1.27mm.step

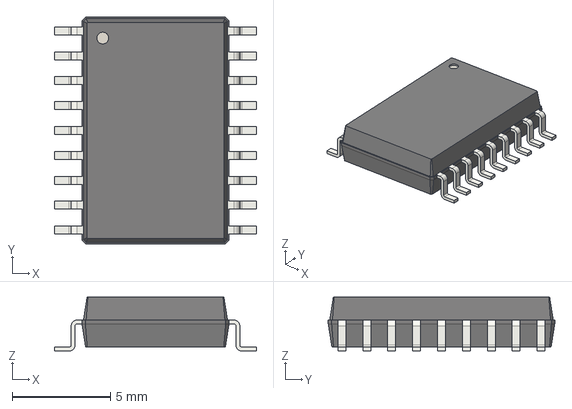
[picture p93: CAD file, 2019-02-02]
_3Dmodels/GullWings_packages/SOIC/SOIC-18W_7.5x11.6mm_Pitch1.27mm.step
10.3 x 11.6 x 2.75 mm
