Roboy/m3/_3Dmodels/DIP_packages/DIP-6_W10.16mm.step

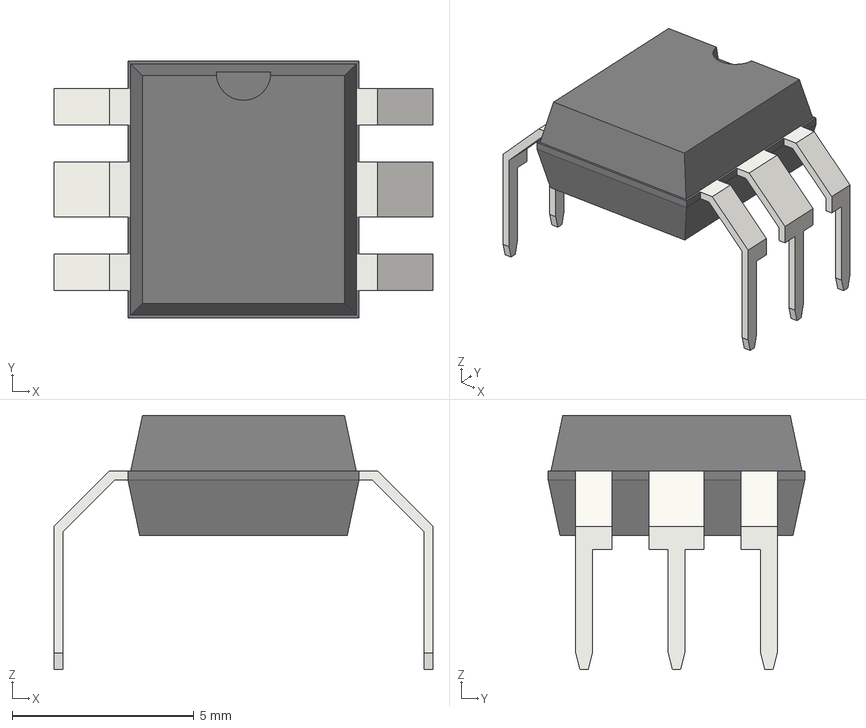
[picture p98: CAD file, 2019-02-02]
_3Dmodels/DIP_packages/DIP-6_W10.16mm.step
10.4 x 7.05 x 6.98 mm
