Roboy/m3/_3Dmodels/GullWings_packages/QFP/LQFP-216_24x24mm_Pitch0.4mm.FCStd

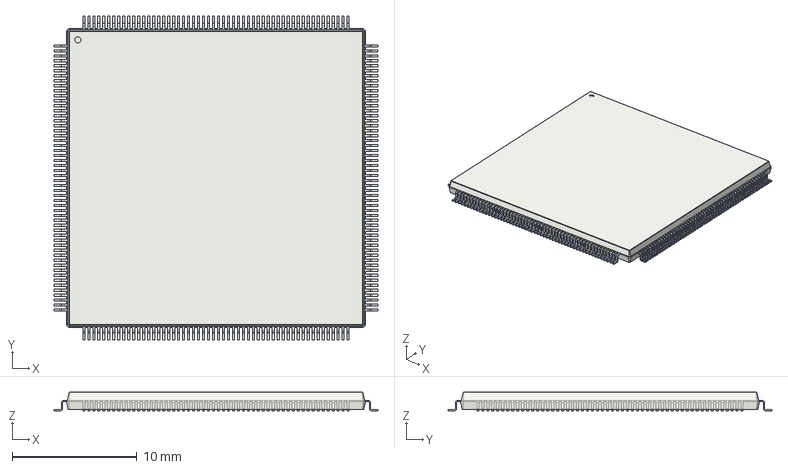
[picture p99: CAD file, 2019-02-02]
_3Dmodels/GullWings_packages/QFP/LQFP-216_24x24mm_Pitch0.4mm.FCStd
26.0 x 26.0 x 1.50 mm
