Roboy/m3/_3Dmodels/BGA_packages/BGA-90_2x3x15_8.0x13.0mm_Pitch0.8mm.step

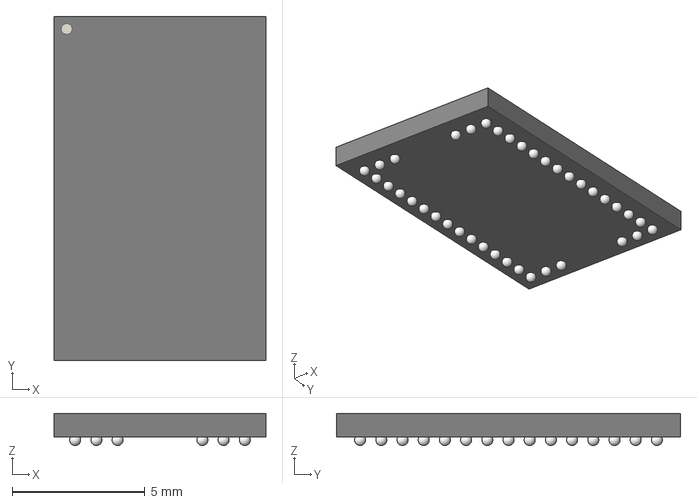
[picture p100: CAD file, 2019-02-02]
_3Dmodels/BGA_packages/BGA-90_2x3x15_8.0x13.0mm_Pitch0.8mm.step
8.00 x 13.0 x 1.21 mm
