Roboy/m3/_3Dmodels/Capacitors_Radial_SMD/CP_Elec_3x5.3.step

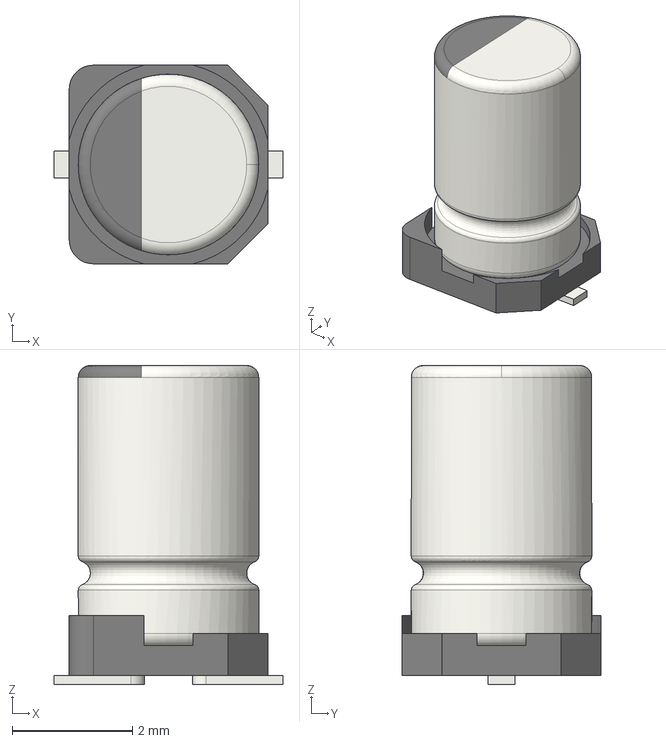
[picture p102: CAD file, 2019-02-02]
_3Dmodels/Capacitors_Radial_SMD/CP_Elec_3x5.3.step
3.80 x 3.30 x 5.30 mm
