Roboy/m3/_3Dmodels/Capacitors_Radial_THT/CP_Radial_D24.0mm_P10.00mm_3pin_SnapIn.step

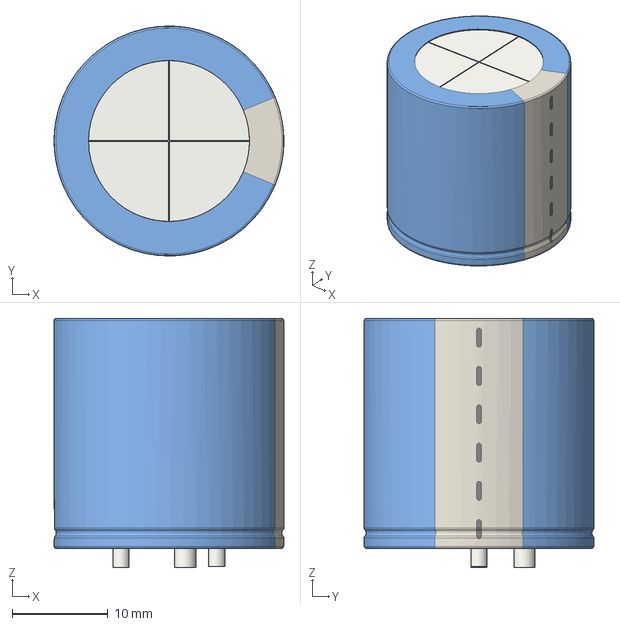
[picture p103: CAD file, 2019-02-02]
_3Dmodels/Capacitors_Radial_THT/CP_Radial_D24.0mm_P10.00mm_3pin_SnapIn.step
24.0 x 24.0 x 26.0 mm
