Roboy/m3/_3Dmodels/Capacitors_Rect_THT/C_Rect_L10.0mm_W2.5mm_P7.50mm_MKS4.step

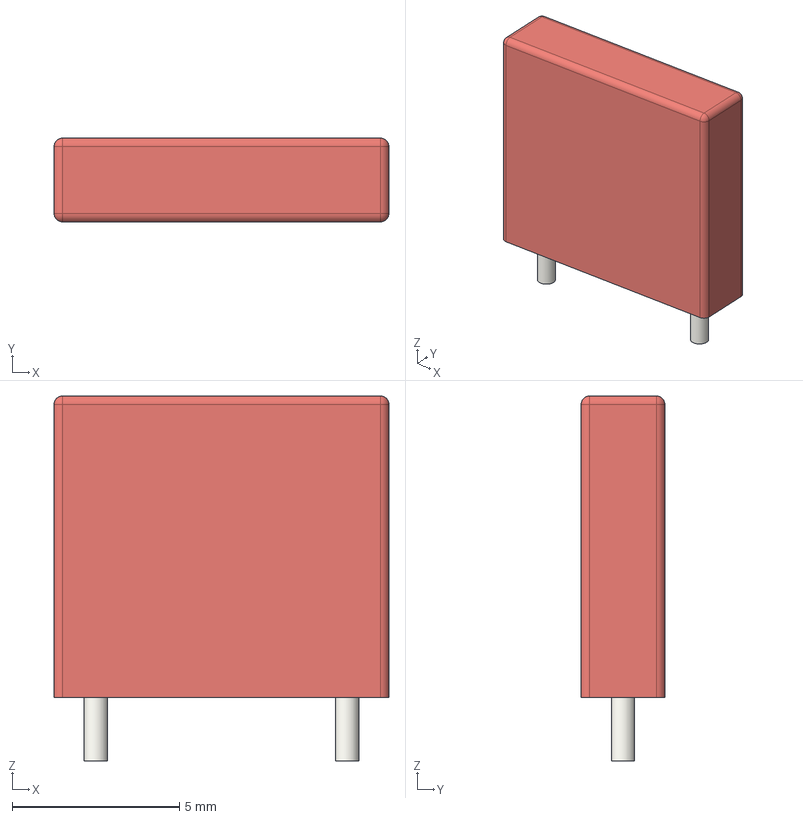
[picture p104: CAD file, 2019-02-02]
_3Dmodels/Capacitors_Rect_THT/C_Rect_L10.0mm_W2.5mm_P7.50mm_MKS4.step
10.0 x 2.50 x 10.9 mm
