Roboy/m3/_3Dmodels/Capacitors_Rect_THT/C_Rect_L11.5mm_W3.6mm_P10.00mm_MKT.step

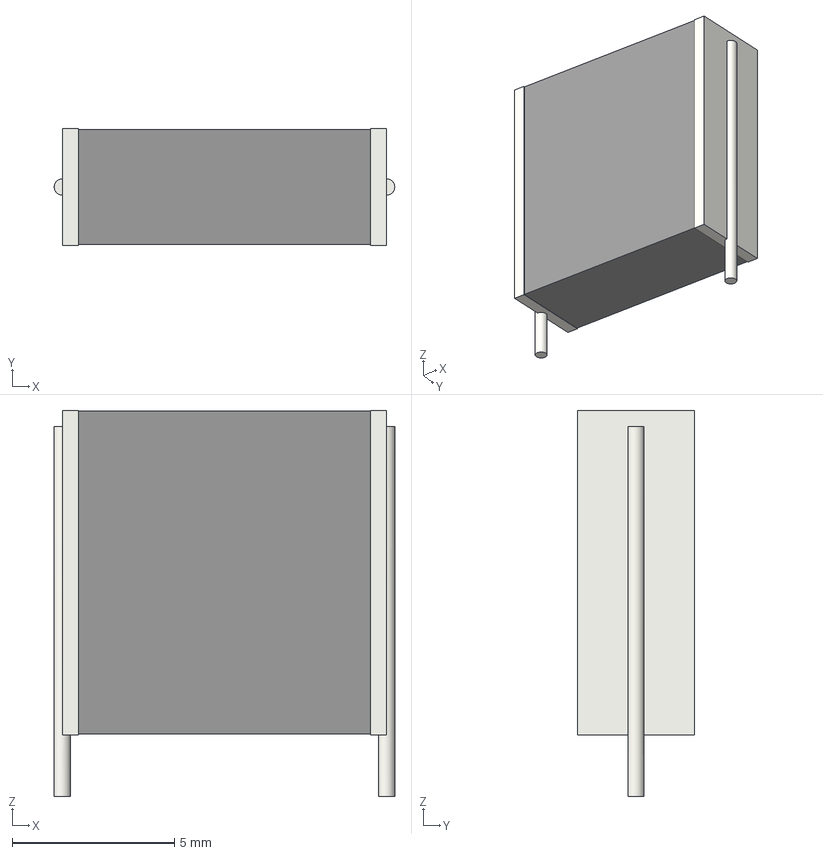
[picture p109: CAD file, 2019-02-02]
_3Dmodels/Capacitors_Rect_THT/C_Rect_L11.5mm_W3.6mm_P10.00mm_MKT.step
10.5 x 3.60 x 11.9 mm
