Roboy/m3/_3Dmodels/DIP_packages/DIP-8_W10.16mm.step

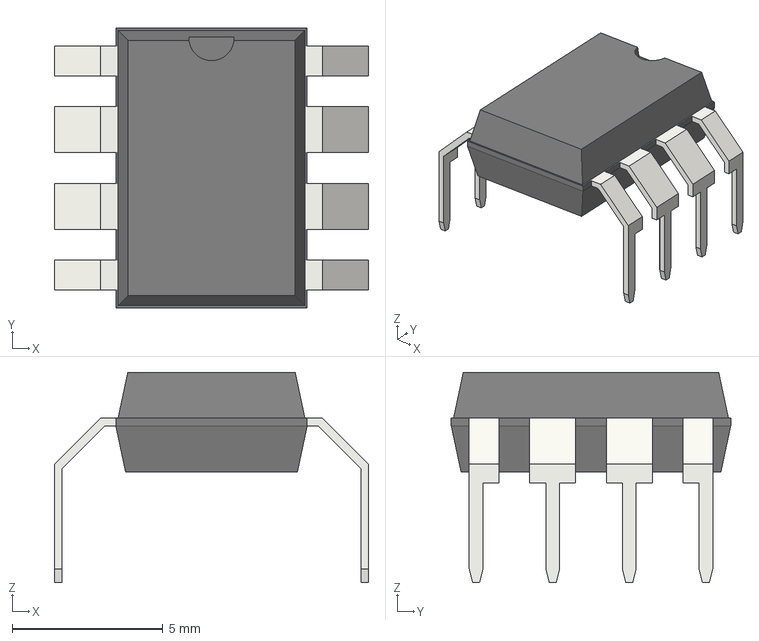
[picture p110: CAD file, 2019-02-02]
_3Dmodels/DIP_packages/DIP-8_W10.16mm.step
10.4 x 9.27 x 6.98 mm
