Roboy/m3/_3Dmodels/Capacitors_Radial_THT/CP_Radial_D17.0mm_P7.50mm.step

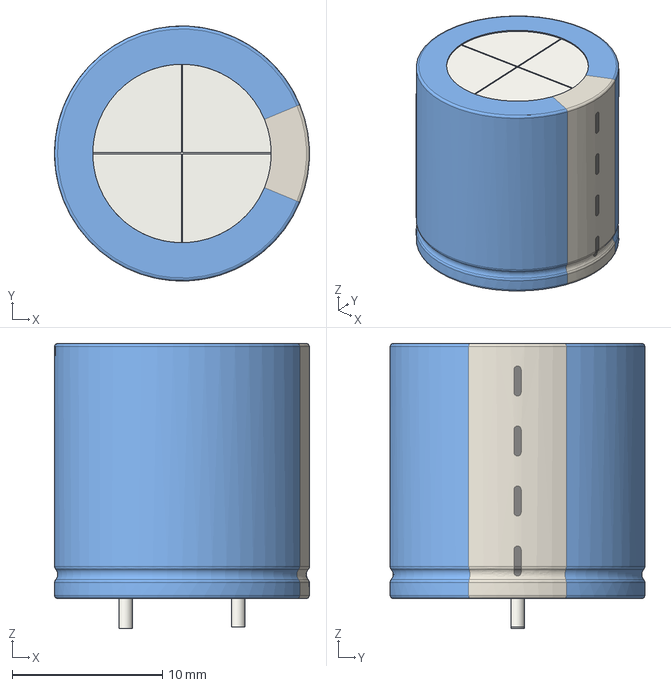
[picture p115: CAD file, 2019-02-02]
_3Dmodels/Capacitors_Radial_THT/CP_Radial_D17.0mm_P7.50mm.step
17.0 x 17.0 x 19.0 mm
