Roboy/m3/_3Dmodels/DIP_packages/DIP-28_W15.24mm.step

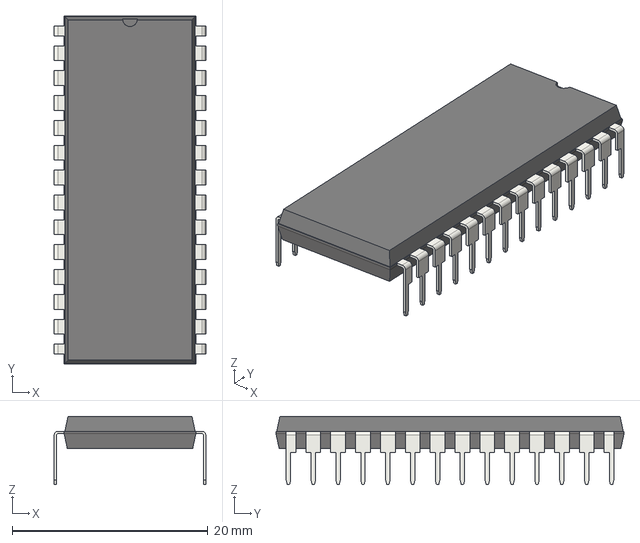
[picture p117: CAD file, 2019-02-02]
_3Dmodels/DIP_packages/DIP-28_W15.24mm.step
15.5 x 35.6 x 6.98 mm
