Roboy/m3/_3Dmodels/GullWings_packages/QFP/TQFP-144_16x16mm_Pitch0.4mm.step

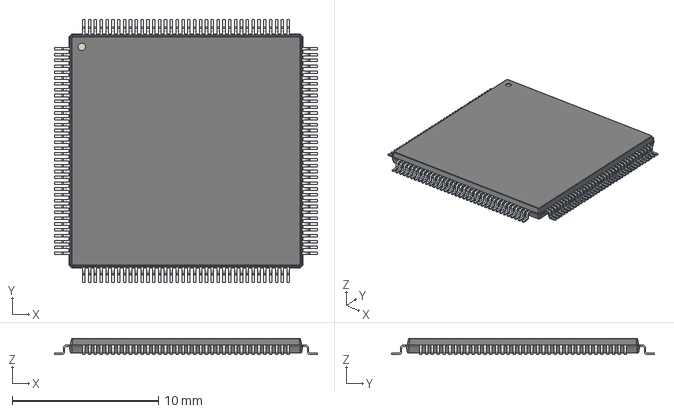
[picture p118: CAD file, 2019-02-02]
_3Dmodels/GullWings_packages/QFP/TQFP-144_16x16mm_Pitch0.4mm.step
18.0 x 18.0 x 1.10 mm
