Roboy/m3/_3Dmodels/Box_Headers/Box_Header_Straight_2x24x2.54mm.step

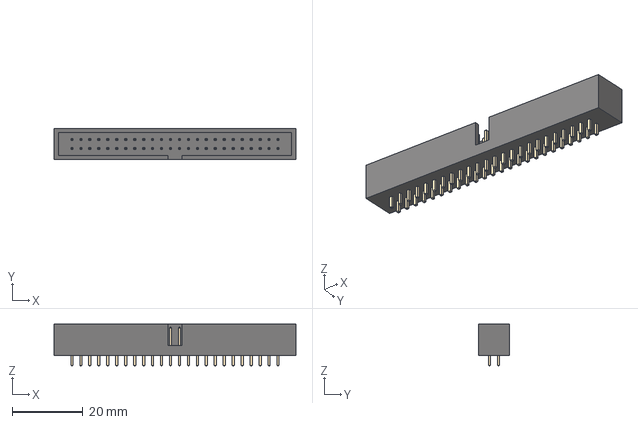
[picture p120: CAD file, 2019-02-02]
_3Dmodels/Box_Headers/Box_Header_Straight_2x24x2.54mm.step
68.6 x 8.90 x 11.9 mm
