Roboy/m3/_3Dmodels/GullWings_packages/QFP/PQFP-80_14x20mm_Pitch0.8mm.step

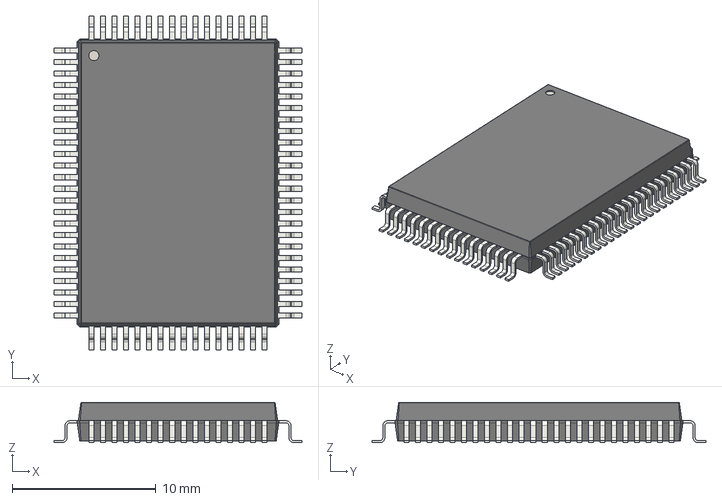
[picture p124: CAD file, 2019-02-02]
_3Dmodels/GullWings_packages/QFP/PQFP-80_14x20mm_Pitch0.8mm.step
17.2 x 23.2 x 2.80 mm
