Roboy/m3/_3Dmodels/BGA_packages/BGA-9_3x3_1.6x1.6mm_Pitch0.5mm.step

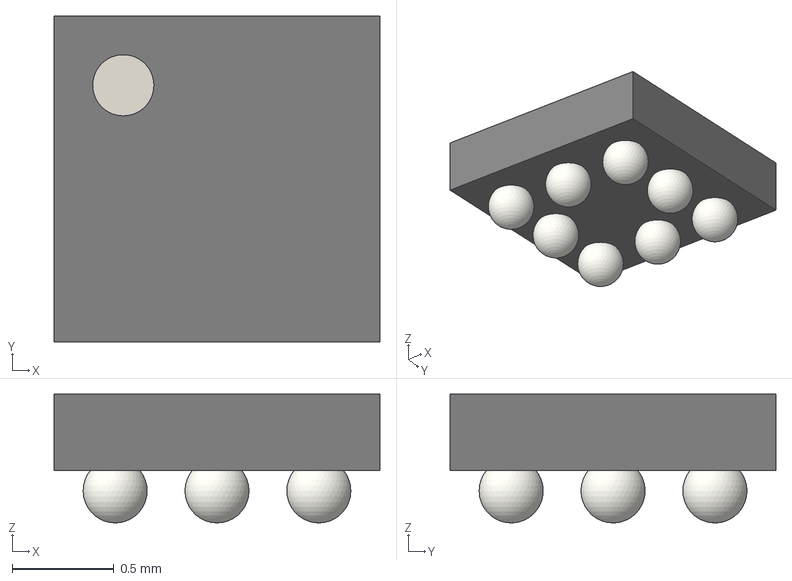
[picture p125: CAD file, 2019-02-02]
_3Dmodels/BGA_packages/BGA-9_3x3_1.6x1.6mm_Pitch0.5mm.step
1.60 x 1.60 x 0.632 mm
