Roboy/m3/_3Dmodels/Capacitors_Radial_THT/CP_Radial_D12.5mm_P2.50mm.step

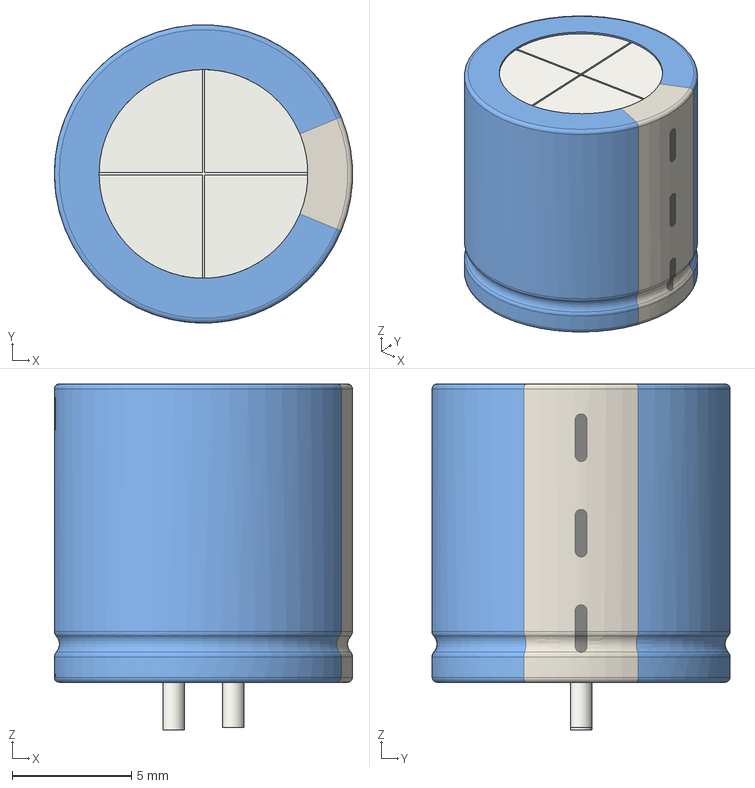
[picture p128: CAD file, 2019-02-02]
_3Dmodels/Capacitors_Radial_THT/CP_Radial_D12.5mm_P2.50mm.step
12.5 x 12.5 x 14.5 mm
