Roboy/m3/_3Dmodels/DIP_packages/DIP-4_W10.16mm.step

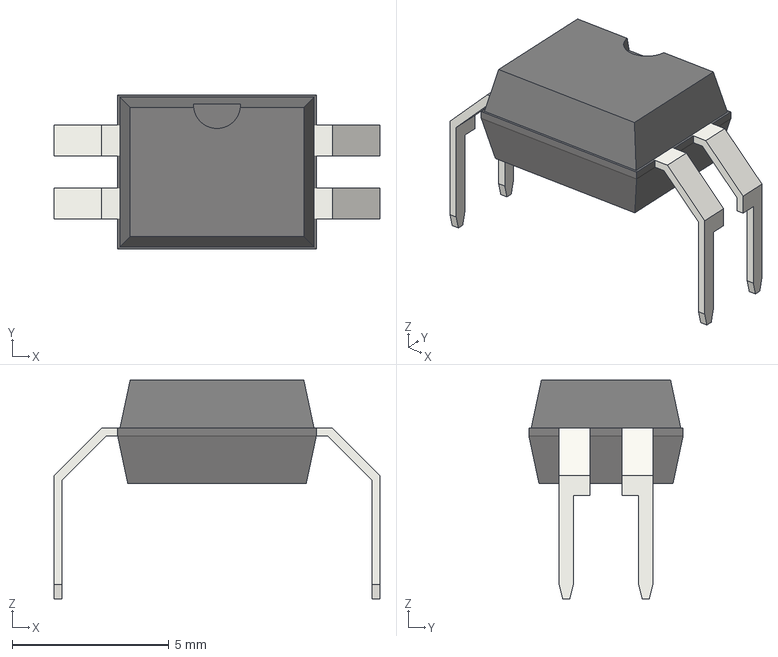
[picture p130: CAD file, 2019-02-02]
_3Dmodels/DIP_packages/DIP-4_W10.16mm.step
10.4 x 4.93 x 6.98 mm
