Roboy/m3/_3Dmodels/BGA_packages/BGA-25_5x5_6.35x6.35mm_Pitch1.27mm.step

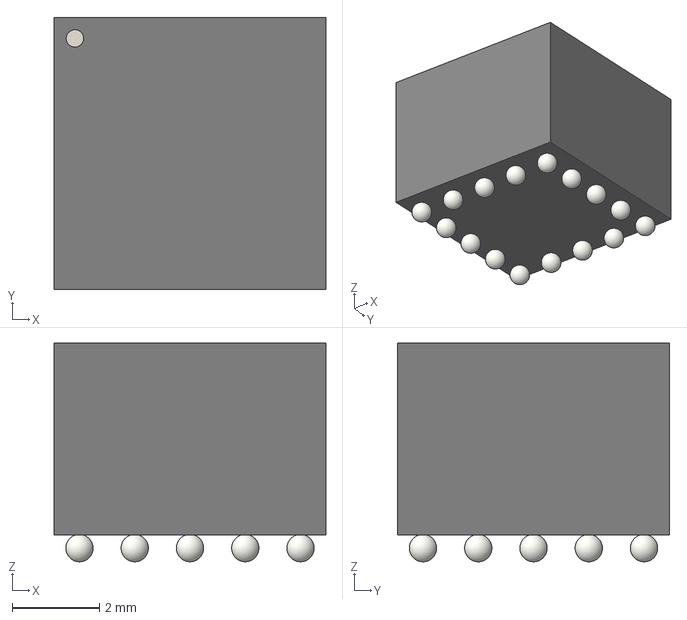
[picture p132: CAD file, 2019-02-02]
_3Dmodels/BGA_packages/BGA-25_5x5_6.35x6.35mm_Pitch1.27mm.step
6.25 x 6.25 x 5.02 mm
