Roboy/m3/_3Dmodels/Capacitors_Radial_THT/CP_Radial_D7.5mm_P2.50mm.step

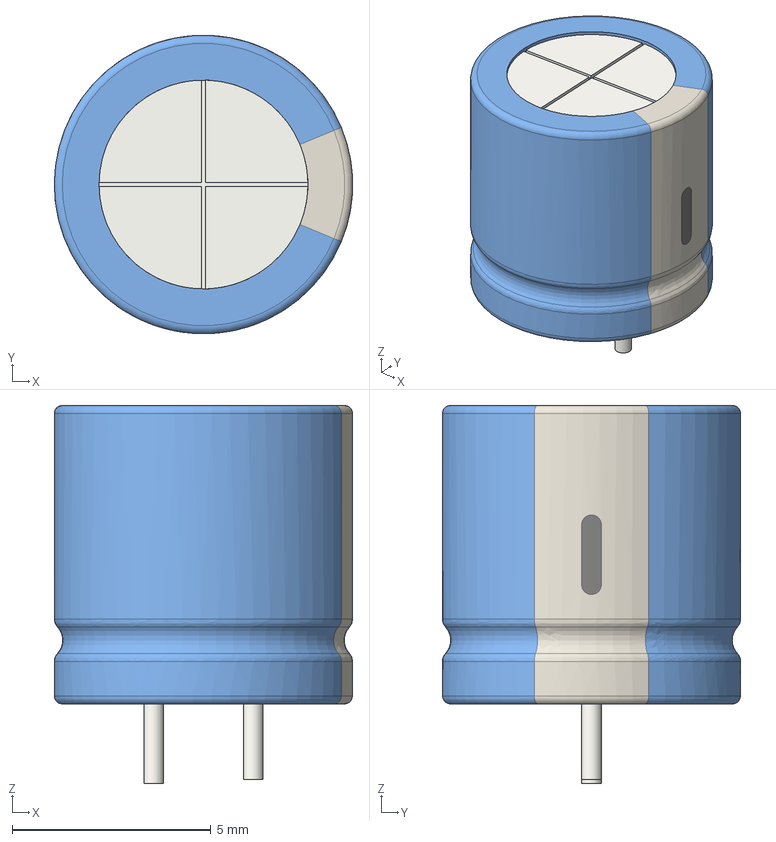
[picture p135: CAD file, 2019-02-02]
_3Dmodels/Capacitors_Radial_THT/CP_Radial_D7.5mm_P2.50mm.step
7.50 x 7.50 x 9.50 mm
