Roboy/m3/_3Dmodels/Capacitors_Rect_THT/C_Rect_L13.0mm_W8.0mm_P10.00mm_FKS3_FKP3_MKS4.step

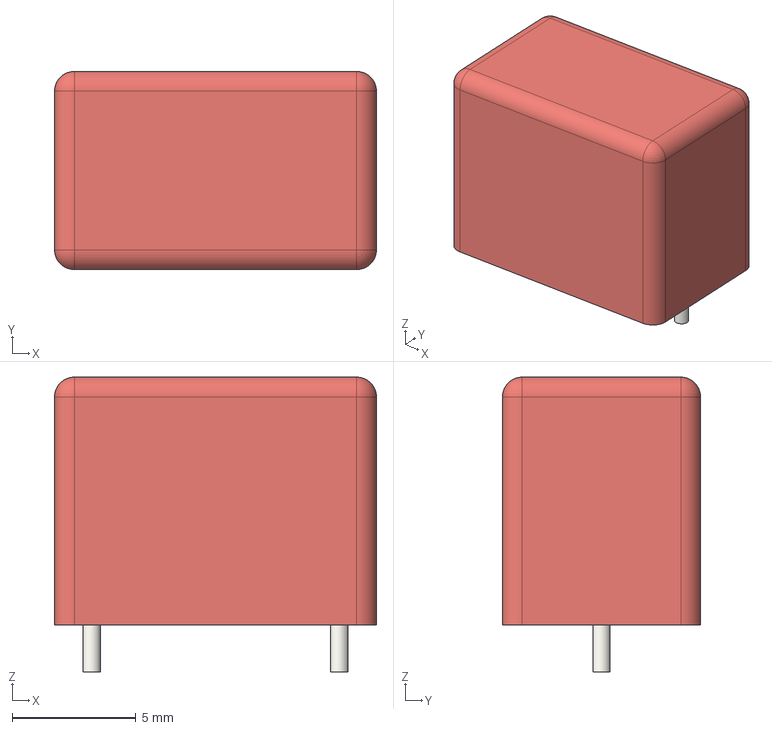
[picture p136: CAD file, 2019-02-02]
_3Dmodels/Capacitors_Rect_THT/C_Rect_L13.0mm_W8.0mm_P10.00mm_FKS3_FKP3_MKS4.step
13.0 x 8.00 x 11.9 mm
