Roboy/m3/_3Dmodels/DIP_packages/DIP-16_W7.62mm.step

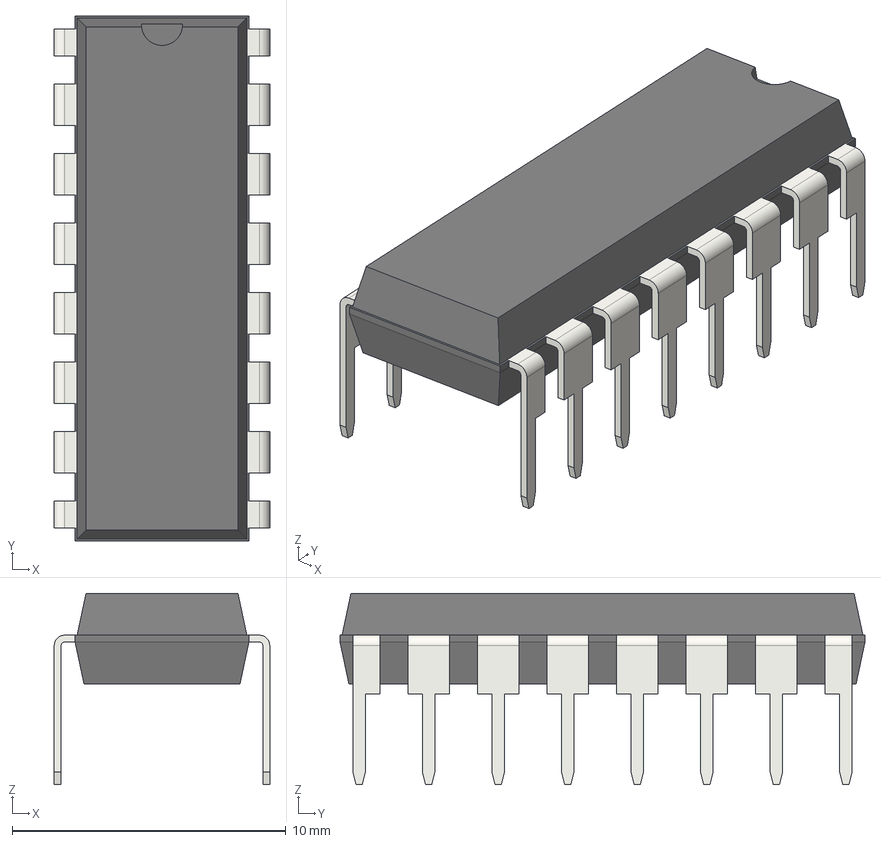
[picture p137: CAD file, 2019-02-02]
_3Dmodels/DIP_packages/DIP-16_W7.62mm.step
7.87 x 19.2 x 6.98 mm
