Roboy/m3/_3Dmodels/Capacitors_Radial_THT/CP_Radial_D30.0mm_P10.00mm_3pin_SnapIn.step

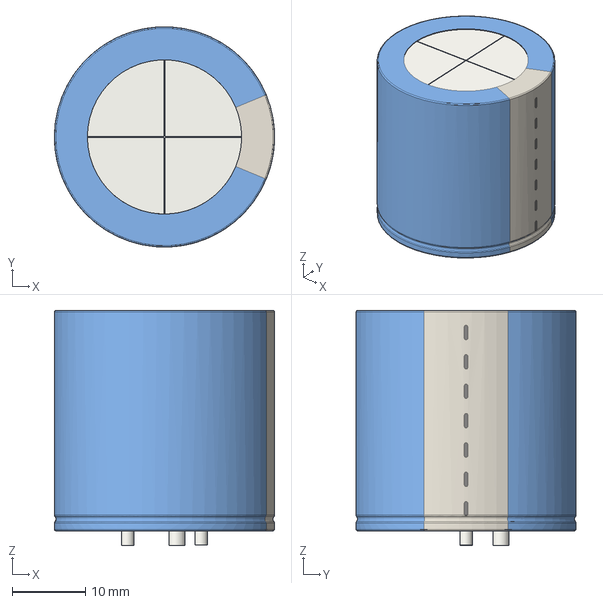
[picture p141: CAD file, 2019-02-02]
_3Dmodels/Capacitors_Radial_THT/CP_Radial_D30.0mm_P10.00mm_3pin_SnapIn.step
30.0 x 30.0 x 32.0 mm
