Roboy/m3/_3Dmodels/Capacitors_Rect_THT/C_Rect_L18.0mm_W6.0mm_P15.00mm_FKS3_FKP3.step

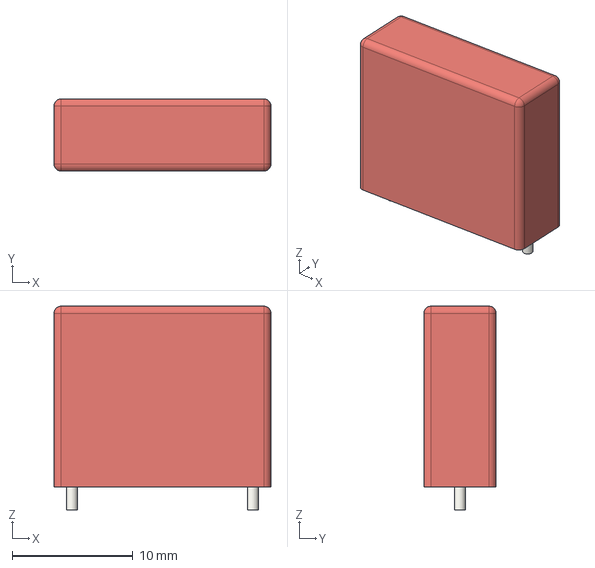
[picture p142: CAD file, 2019-02-02]
_3Dmodels/Capacitors_Rect_THT/C_Rect_L18.0mm_W6.0mm_P15.00mm_FKS3_FKP3.step
18.0 x 6.00 x 16.9 mm
