Roboy/m3/_3Dmodels/DIP_packages/DIP-8_W7.62mm.step

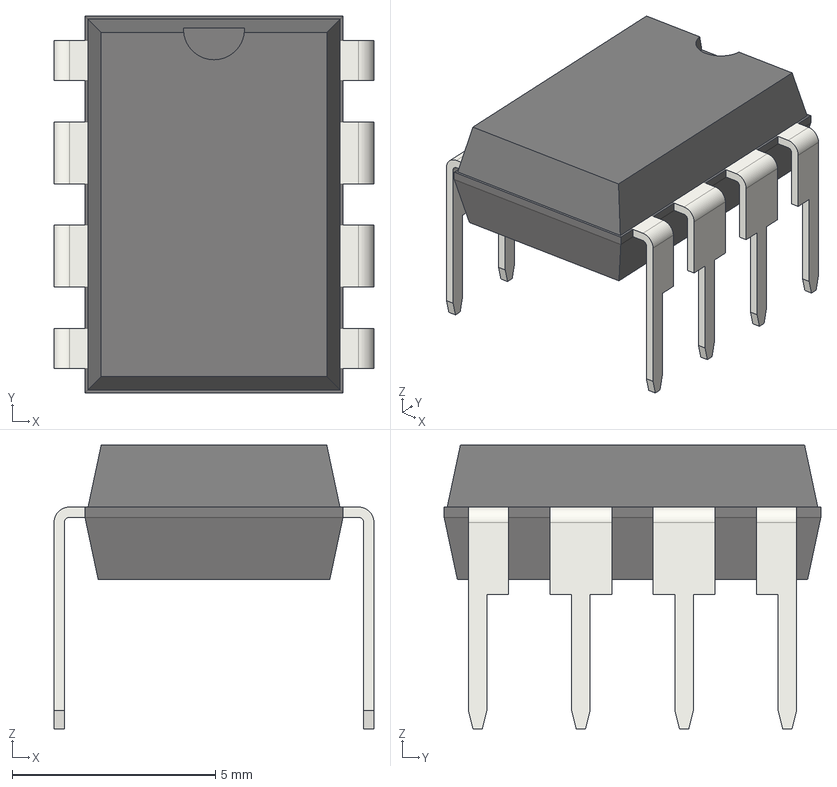
[picture p143: CAD file, 2019-02-02]
_3Dmodels/DIP_packages/DIP-8_W7.62mm.step
7.87 x 9.27 x 6.98 mm
