Roboy/m3/roboy_sno.kicad_pcb

## KiCad design roboy_sno.kicad_pcb (2020-03-12)

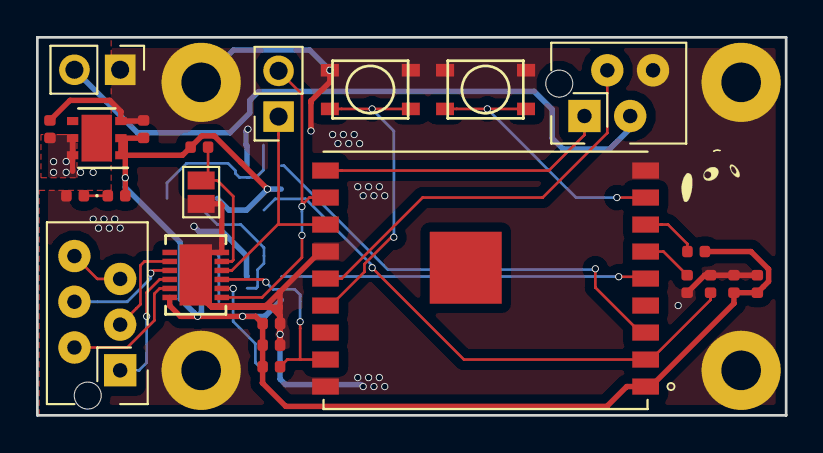
[picture p144: board roboy_sno.kicad_pcb from above]

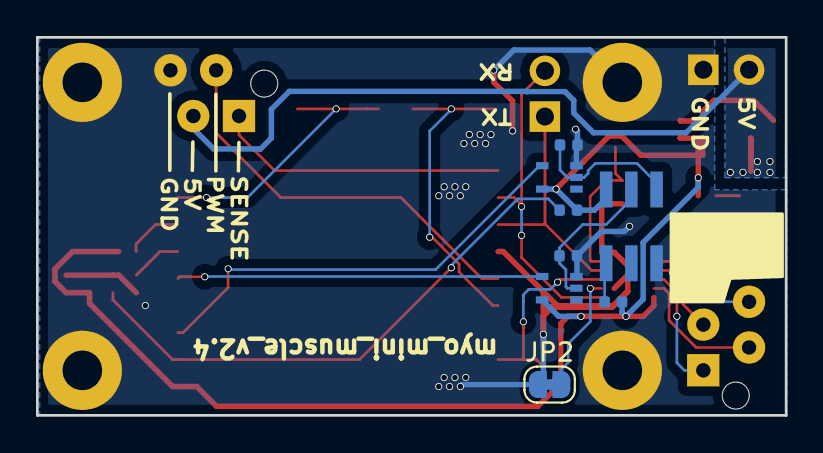
[picture p145: board roboy_sno.kicad_pcb from below]

Board: 2 copper layers, 41.6 x 21.0 mm, 38 parts (8 on the bottom side), 26 nets.

Parts:
C1, C2, C3, C5: 0.1uF; C_0402_1005Metric
C4, C6, C7: 10uF; C_0402_1005Metric
D1: LED; LED_0402_1005Metric
H1, H2, H6, H7: MountingHole; MountingHole_2.2mm_M2_Pad
H3: LABEL; R1_ear_silk_5.5mm
H4: LABEL; R1_eyes_mask_5.5mm
H5: LABEL; R1_face_mask_5.5mm
J1, J2: SCHMITT_TRIGGER; SC70-5
J3: UART; PinSocket_1x02_P2.54mm_Vertical
J4: power; PinHeader_1x02_P2.54mm_Vertical
J5: Conn_01x04_Male; TE-Connectivity_Micro-Match_connector_02x02_Pitch_1.27mm
J6: tcut1350; tcut1350x01
J7: ICEBUS; TE-Connectivity_Micro-Match_connector_02x03_Pitch_1.27mm
JP1: SolderJumper_2_Open; SolderJumper-2_P1.3mm_Open_Pad1.0x1.5mm
JP2: SolderJumper_2_Bridged; SolderJumper-2_P1.3mm_Bridged_RoundedPad1.0x1.5mm
R1, R2, R3, R4, R8, R9: 10k; R_0402_1005Metric
R5, R6: 2k; R_0402_1005Metric
R7: 47; R_0402_1005Metric
SW1: RESET; PTS815-SJK
SW2: BOOT; PTS815-SJK
U1: LTC2855CDEPBF; ltc2855
U2: ESP-WROOM-02U; MODULE_ESP-WROOM-02U
U3: LD39200; DFN-6-1EP_3x3mm_P0.95mm_EP1.7x2.6mm

Connections:
+3V3: C2.1, C3.1, C4.2, C5.1, C6.2, D1.2, J1.5, J2.5, J6.3, R1.1, R2.2, R3.2, R7.1, R9.2, U1.12, U2.1, U3.1, U3.2
+5V: C7.2, J4.2, J5.3, U3.5, U3.6
/h_Rx: J7.2, U1.11
/h_Tx: J7.4, U1.9
/l_Rx: J7.1, U1.10
/l_Tx: J7.3, U1.8
/term_te: JP1.1, R2.1, U1.5
DE: R9.1, U1.3, U2.17
E0: J1.2, J6.1, R5.1
E0_filtered: J1.4, U2.3
E1: J2.2, J6.2, R6.2
E1_filtered: J2.4, U2.5
GND: C1.1, C2.2, C3.2, C4.1, C5.2, C6.1, C7.1, H1.1, H2.1, H6.1, H7.1, J1.3, J2.3, J4.1, J5.4, J6.6, JP1.2, JP2.1, R4.2, R5.2, R6.1, R8.1, SW1.1, SW2.1, U1.6, U1.13, U2.9, U2.13, U2.18, U3.3
MOTOR: J5.2, U2.14
MOTOR_SENSE: J5.1, U2.10
unnamed: C1.2, R3.1, U2.2
unnamed: D1.1, R8.2
unnamed: J6.4, R7.2
unnamed: JP2.2, U1.2
unnamed: R1.2, U2.7
unnamed: R4.1, U2.6
unnamed: SW1.2, U2.15
unnamed: SW2.2, U2.8
RXD: J3.2, U1.1, U2.11
SHIELD: J7.5, J7.6
TXD: J3.1, U1.4, U2.12
