Roboy/m3/pcbs/tcut1350_test/tcut1350_test.kicad_pcb

## KiCad design pcbs/tcut1350_test/tcut1350_test.kicad_pcb (2020-01-17)

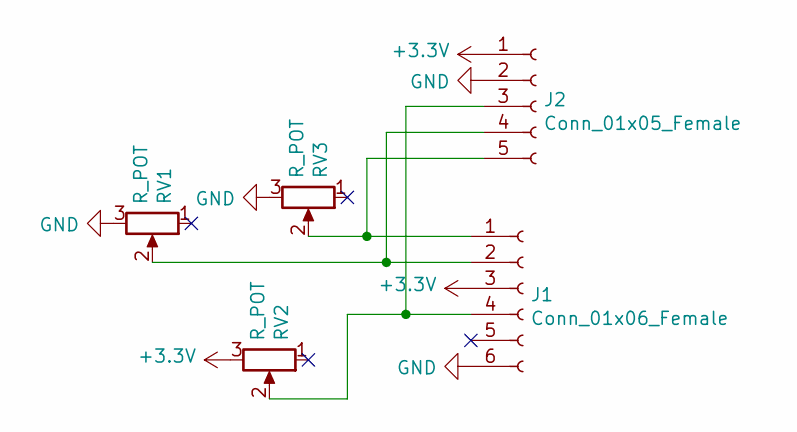
[picture p146: schematic tcut1350_test.sch]

Parts:
J1: Conn_01x06_Female; tcut1350x01
J2: Conn_01x05_Female; PinSocket_1x05_P2.54mm_Vertical
RV1, RV2, RV3: R_POT; Potentiometer_Bourns_PTA2043_Single_Slide

Connections:
+3V3: J1.3, J2.1, RV2.3
GND: J1.6, J2.2, RV1.3, RV3.3
unnamed: J1.1, J2.5, RV3.2
unnamed: J1.2, J2.4, RV1.2
unnamed: J1.4, J2.3, RV2.2

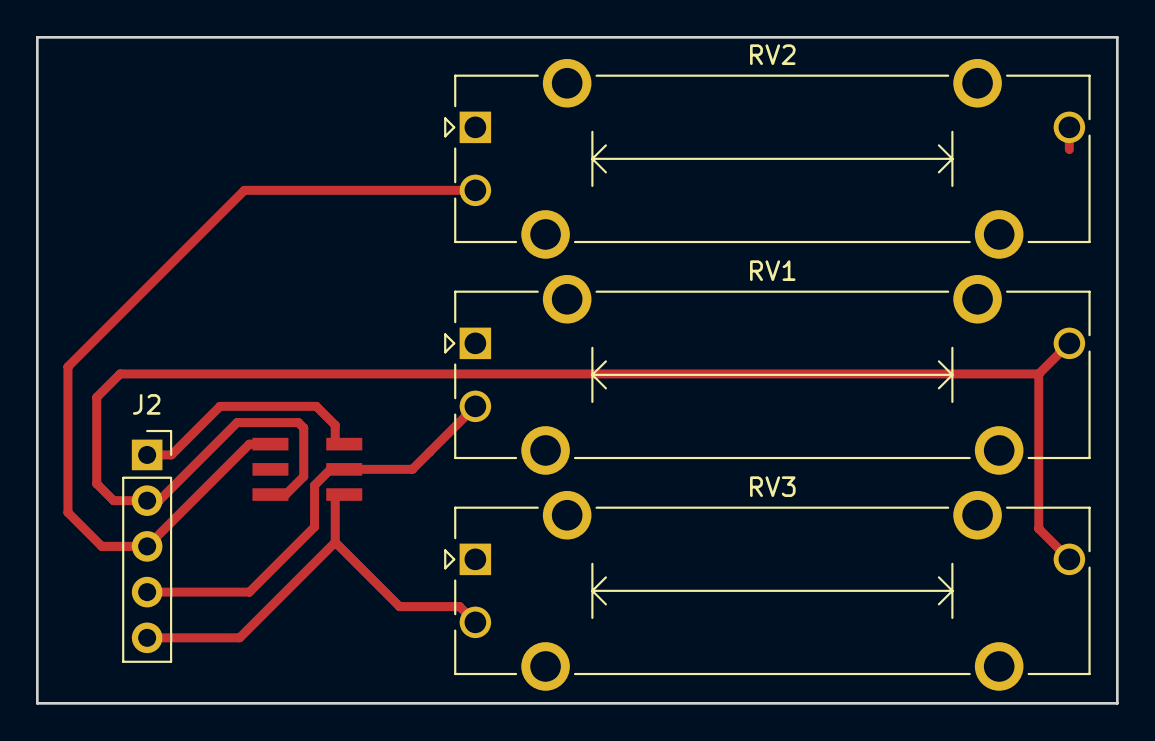
[picture p147: board tcut1350_test.kicad_pcb from above]

Board: 2 copper layers, 60.0 x 37.0 mm, 5 parts (0 on the bottom side), 5 nets.
