Roboy/m3/(commit log)

2018-12-28 done pcb layout
    [roboy_sno.kicad_pcb, roboy_sno.sch]
2019-01-03 with stl export
    [m3.stl]
2019-02-02 esp32-wroom-2d without usb->uart
    [roboy_sno.kicad_pcb, roboy_sno.sch]
2019-02-02 esp-wroom32 ready
    [4UCON_17809_02x10x1.27mm_Vertical.FCStd, 4UCON_17809_02x10x1.27mm_Vertical.step, 4UCON_17809_02x40x1.27mm_Vertical.FCStd, BGA-100_10x10_9.0x9.0mm_Pitch0.8mm.FCStd, BGA-100_10x10_9.0x9.0mm_Pitch0.8mm.step, BGA-1023_32x32_33.0x33.0mm_Pitch1.0mm.FCStd, BGA-1023_32x32_33.0x33.0mm_Pitch1.0mm.step, BGA-1156_34x34_35.0x35.0mm_Pitch1.0mm.FCStd]
2019-05-09 with freertos version, servo and angle working already
2019-05-10 with bigger esp32
    [roboy_sno.sch]
2019-05-10 new version with esp32 ready and ordered on pcbway
    [m3_2x4_panel-B.Cu.gbr, m3_2x4_panel-B.Mask.gbr, m3_2x4_panel-B.Paste.gbr, m3_2x4_panel-B.SilkS.gbr, m3_2x4_panel-Edge.Cuts.gbr, m3_2x4_panel-F.Cu.gbr, m3_2x4_panel-F.Mask.gbr, m3_2x4_panel-F.Paste.gbr]
2019-05-12 with pcb step export
    [ESP32-WROOM-32D--3DModel-STEP-56544.STEP, roboy_sno.cfg, roboy_sno.kicad_pcb, roboy_sno1.FCStd]
2019-05-12 better motor pins placdement
    [m3.stl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]
2019-05-14 pcbway requirements
    [m3_2x5_panel-B.Cu.gbr, m3_2x5_panel-B.Mask.gbr, m3_2x5_panel-B.Paste.gbr, m3_2x5_panel-B.SilkS.gbr, m3_2x5_panel-B_Cu.gbr, m3_2x5_panel-B_Mask.gbr, m3_2x5_panel-B_Paste.gbr, m3_2x5_panel-B_SilkS.gbr]
2019-05-14 with schematics
    [roboy_sno1.FCStd]
2019-05-15 with corrected ground plane
    [m3_2x5_panel-B.Cu.gbr, m3_2x5_panel-B.Mask.gbr, m3_2x5_panel-B.Paste.gbr, m3_2x5_panel-B.SilkS.gbr, m3_2x5_panel-Cmts.User.gbr, m3_2x5_panel-Edge.Cuts.gbr, m3_2x5_panel-F.Cu.gbr, m3_2x5_panel-F.Mask.gbr]
2019-05-15 adc draft
2019-05-16 adc draft done
2019-05-17 final pcb order?
    [m3_2x5_panel-B.Cu.gbr, m3_2x5_panel-B.Mask.gbr, m3_2x5_panel-B.Paste.gbr, m3_2x5_panel-B.SilkS.gbr, m3_2x5_panel-Cmts.User.gbr, m3_2x5_panel-Edge.Cuts.gbr, m3_2x5_panel-F.Cu.gbr, m3_2x5_panel-F.Mask.gbr]
2019-05-23 with stepper motor control example
2019-05-27 with real pinout of m3 units
    [100ask-openjtag.cfg, 8devices-lima.cfg, actux3.cfg, adapteva_parallella1.cfg, alphascale_asm9260_ek.cfg, altera-10m50.cfg, altera-ep3c10.cfg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]
2019-05-28 with buttons
    [roboy_sno.cfg, roboy_sno.kicad_pcb, roboy_sno1.FCStd]
2019-10-09 we need float gains at least
    [roboy_sno.sch]
2019-11-22 with optical encoder
    [m3.csv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]
2019-11-25 with optical encoder step
    [roboy_sno.kicad_pcb]
2019-12-03 make it small
    [m3_v2.1_pcb.step, roboy_sno.kicad_pcb, roboy_sno.sch]
2019-12-11 using optical encoder
    [m3_v2.1.step, roboy_sno.kicad_pcb, roboy_sno.sch]
2020-01-02 rev 2.2 ordered on aisler
    [m3_2x5_panel-B.Cu.gbr, m3_2x5_panel-B.Mask.gbr, m3_2x5_panel-B.Paste.gbr, m3_2x5_panel-B.SilkS.gbr, m3_2x5_panel-Cmts.User.gbr, m3_2x5_panel-Edge.Cuts.gbr, m3_2x5_panel-F.Cu.gbr, m3_2x5_panel-F.Mask.gbr]
2020-01-13 changed pwm and motor sense to io 4/5, because the bloddy io16 cannnot be used as an interrupt pin
    [roboy_sno-B.Cu.gbr, roboy_sno-B.Mask.gbr, roboy_sno-B.Paste.gbr, roboy_sno-B.SilkS.gbr, roboy_sno-Edge.Cuts.gbr, roboy_sno-F.Cu.gbr, roboy_sno-F.Mask.gbr, roboy_sno-F.Paste.gbr]
2020-01-17 with test circuit for optical encoder
    [tcut1350_test.kicad_pcb, tcut1350_test.sch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]
2020-01-30 shitty low-pass filter
2020-01-30 schmitt trigger adapter
    [schmitt_trigger_adapter-B.Cu.gbr, schmitt_trigger_adapter-B.Mask.gbr, schmitt_trigger_adapter-B.Paste.gbr, schmitt_trigger_adapter-B.SilkS.gbr, schmitt_trigger_adapter-Edge.Cuts.gbr, schmitt_trigger_adapter-F.Cu.gbr, schmitt_trigger_adapter-F.Mask.gbr, schmitt_trigger_adapter-F.Paste.gbr]
2020-02-19 fixed bug in smitt-trigger adapter
    [m3_v2.1.step, m3_v2.1_pcb.step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]
2020-03-05 with rs485
    [output.schmitt_trigger_adapter-B.Cu.gbr, output.schmitt_trigger_adapter-B.Mask.gbr, output.schmitt_trigger_adapter-B.Paste.gbr, output.schmitt_trigger_adapter-B.SilkS.gbr, output.schmitt_trigger_adapter-Edge.Cuts.gbr, output.schmitt_trigger_adapter-F.Cu.gbr, output.schmitt_trigger_adapter-F.Mask.gbr, output.schmitt_trigger_adapter-F.Paste.gbr]
2020-03-05 with bom
    [BOM.csv, m3_panel.kicad_pcb, output.m3_2x5_panel.kicad_pcb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]
2020-03-12 bigger panel
    [BOM.csv, BOM_all_parts.csv, m3_2x5_panel.kicad_pcb, m3_panel.kicad_pcb, output.m3_2x5_panel.kicad_pcb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]
2020-03-16 mouse bite bigger distances
    [output.m3_panel-B.Cu.gbr, output.m3_panel-B.Mask.gbr, output.m3_panel-B.Paste.gbr, output.m3_panel-B.SilkS.gbr, output.m3_panel-Edge.Cuts.gbr, output.m3_panel-F.Cu.gbr, output.m3_panel-F.Mask.gbr, output.m3_panel-F.Paste.gbr]
2020-03-17 fixed create array
    [m3_panel.kicad_pcb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]
2020-06-25 with optical encoder footprint
    [optical_encoder.kicad_pcb, optical_encoder.sch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]
2020-07-07 with tolerances
    [optical_encoder.kicad_pcb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]
2021-02-03 Fixed angle readout implementation and priorities. Started converting pwm task for servo to proper library. Fixed setpoint being uint32_t, it should be signed.
    [main.c]
2021-02-03 PWM and control computation working properly now. Adjusted some initial conditions and enabled full PWM by default (servo isn't too fast). Culprits were some esoteric default casting issues, see comm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
    [main.c]
2021-02-04 Included sample period in PID computation everything much smoother now. Implemented derivative of process variable to prevent derivative kick, also derivative exponential average filtering. On the fl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
    [main.c]
2021-02-09 Implemented velocity calculation and filtering, and tuned loop parameters. Position data is now filtered, also reduced tolerance for cycle time mismatch (should get more accurate readings). Finally i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
    [main.c]
2021-02-09 Added protection when trying to set a displacement with the wrong sign relative to the mirrored setting.
    [main.c]
2021-02-10 PWM limit can now be set via icebus. Was set constant during testing.
2021-02-10 Removed spooling reversal protection for displacement mode.
    [main.c]
2021-02-14 Updated filter coefficient for position sensor. Now equivalent to averaging roughly 9 samples, w = 2/(k+1).
